maleadt/thesis-adastra3/scriptie/0_acronyms.tex

\begin{acronym}[WYSIWYG]	% langste afkorting
\acro{abi}[ABI]{Application Binary Interface}
\acro{agpl}[AGPL]{\acs{gnu} Affero General Public License}
\acro{ajax}[Ajax]{Asynchronous JavaScript and XML}
\acro{ajp}[AJP]{Apache JServ Protocol}
\acro{api}[API]{Application Programming Interface}
\acro{arm}[ARM]{Advanced \acs{risc} Machine}
\acro{cc-by}[CC-BY]{\acl{cc} Attribution}
\acro{cc}[CC]{Creative Commons}
\acro{cc-sa}[CC-SA]{\acl{cc} ShareAlike}
\acro{corba}[CORBA]{Common Object Request Broker Architecture}
\acro{cpu}[CPU]{Central Processing Unit}
\acro{css}[CSS]{Cascading Style Sheet}
\acro{dcp}[DCP]{Device Control Protocol}
\acro{dhcp}[DHCP]{Dynamic Host Configuration Protocol}
\acro{dns}[DNS]{Domain Name System}
\acro{dru}[DRU]{Design Rules}
\acro{dsp}[DSP]{Digital Signal Processor}
\acro{dvd}[DVD]{Digital Versatile Disc}
\acro{eabi}[EABI]{Embedded \acs{abi}}
\acro{eeprom}[EEPROM]{Electrically Erasable Programmable Read-Only Memory}
\acro{fpu}[FPU]{Floating-Point Unit}
\acro{fsf}[FSF]{Free Software Foundation}
\acro{ftp}[FTP]{File Transfer Protocol}
\acro{gcc}[GCC]{\acs{gnu} compiler collection}
\acro{gnu}[GNU]{GNU's Not Unix!}
\acro{gpl}[GPL]{\acs{gnu} General Public License}
\acro{gpu}[GPU]{Graphics Processing Unit}
\acro{hid}[HID]{Human Interface Device}
\acro{html}[HTML]{Hypertext Markup Language}
\acro{http}[HTTP]{Hypertext Transport Protocol}
\acro{hvsp}[HVSP]{High-Voltage Serial Programming}
\acro{ip}[IP]{Internet Protocol}
\acro{isp}[ISP]{In-System Programming}
\acro{jar}[JAR]{Java ARchive}
\acro{jit}[JIT]{Just In Time}
\acro{jna}[JNA]{Java Native Access}
\acro{jni}[JNI]{Java Native Interface}
\acro{jre}[JRE]{Java Runtime Environment}
\acro{jtag}[JTAG]{Joint Test Action Group}
\acro{jvm}[JVM]{Java Virtual Machine}
\acro{kde}[KDE]{K Desktop Environment}
\acro{lan}[LAN]{Local Area Network}
\acro{lgpl}[LGPL]{\acs{gnu} Lesser General Public License}
\acro{lufa}[LUFA]{Lightweight USB Framework for AVRs}
\acro{mac}[MAC]{Media Access Control}
\acro{maven}[Maven]{Apache Maven}
\acro{mdns}[mDNS]{Multicast \acs{dns}}
\acro{mit}[MIT]{Massachusetts Institute of Technology}
\acro{moc}[MOC]{Meta-Object Compiler}
\acro{mpl}[MPL]{Mozilla Public License}
\acro{nas}[NAS]{Network Attached Storage}
\acro{oabi}[OABI]{Old \acs{abi}}
\acro{ohl}[OHL]{Open Hardware License}
\acro{pcb}[PCB]{Printed Circuit Board}
\acro{pll}[PLL]{Phase-Locked Loop}
\acro{pom}[POM]{Project Object Model}
\acro{raid}[RAID]{Redundant Array of Independent Disks}
\acro{ram}[RAM]{Random Access Memory}
\acro{rest}[REST]{Representational State Transfer}
\acro{rhel}[RHEL]{Red Hat Enterprise Linux}
\acro{risc}[RISC]{Reduced Instruction Set Computer}
\acro{rmi}[RMI]{Remote Method Invocation}
\acro{rpc}[RPC]{Remote Procedure Call}
\acro{sasl}[SASL]{Simple Authentication and Security Layer}
\acro{scpd}[SCPD]{Service Control Protocol Description}
\acro{sd}[SD]{Secure Digital}
\acro{sl}[SL]{Scientific Linux}
\acro{soap}[SOAP]{Simple Object Access Protocol}
\acro{soc}[SoC]{System-on-a-Chip}
\acro{srt}[SRT]{SubRip subtitle}
\acro{ssdp}[SSDP]{Simple Service Discovery Protocol}
\acro{ssl}[SSL]{Secure Socket Layer}
\acro{svn}[SVN]{Apache Subversion}
\acro{uart}[UART]{Universal Asynchronous Receiver/Transmitter}
\acro{upnp}[UPnP]{Universal Plug and Play}
\acro{usb}[USB]{Universal Serial Bus}
\acro{uuid}[UUID]{Universally Unique Identifier}
\acro{webdav}[WebDAV]{Web-based Distributed Authoring and Versioning}
\acro{wtfpl}[WTFPL]{Do What The Fuck You Want Public License}
\acro{wysiwyg}[WYSIWYG]{What You See Is What You Get}
\acro{xml}[XML]{eXtensible Markup Language}
\acro{xsd}[XSD]{XML Schema Definition}
\end{acronym}
