maleadt/thesis-adastra3/scriptie/4_inputmodule.tex

\part{Inputmodule}
\label{inputmodule}

\chapter{Hardware}
\label{inputmodule:hardware}

Zoals uit de doeken gedaan in deel \ref{ontwerp}, zullen we voor de module gebruik maken van een AVR microcontroller met daarop de V-USB firmware om low-speed datacommunicatie te verwezenlijken met minimale periferie.

\section{Microcontroller}
\label{inputmodule:hardware:microcontroller}

Door het gebruik van de V-USB bibliotheek moeten we ons beperken tot AVR microcontrollers, maar binnen die familie is het aanbod nog altijd zeer groot. Om een goede selectie te maken, moeten we logischerwijs rekening houden met de eisen die de V-USB bibliotheek stelt:
\begin{itemize}
\item Flash: tenminste 2 kB;
\item RAM: tenminste 128 bytes;
\item Kloksnelheid: 12.8 of 16.5 MHz bij gebruik van een interne oscillator, en ook 12, 15, 16 of 20 MHz indien we gebruik maken van een extern kristal\footnote{Dit omdat enkel de 12.8 en 16.5 MHz frequenties een deviatie van 1\% toelaten, en het bij de interne oscillator onmogelijk is om een heel precieze afstelling te bekomen.};
\item Poorten: exact 2, beide met een interruptlijn.
\end{itemize}

We willen echter ook een uitbreidbare module realiseren. Momenteel hebben we slechts 4 knoppen aan te sluiten, maar mogelijks worden dit er later meer. Daarom zullen we ruimte laten voor drie extra knoppen, wat we eenvoudig kunnen realiseren met slechts 4 poorten door het signaal te multiplexen. Als we tenslotte overlappingen negeren, volstaat het zelfs om maar 3 poorten te gebruiken.

Tenslotte zou het ook interessant zijn moest de microcontroller voorzien zijn van \ac{isp} headers, waardoor de firmware van de module achteraf nog kan vernieuwd worden zonder daarvoor de microcontroller te moeten verwijderen uit de module. Indien we het echter mogelijk willen maken om de chip te herprogrammeren via \ac{isp}, kunnen we geen gebruik maken van \ac{hvsp} (waarvoor de chip fysiek in een \ac{hvsp} programmer moet geplaatst worden). \ac{hvsp} is een speciale methode om een microcontroller te programmeren, waarbij het mogelijk is om voordien ingestelde \emph{fuses} opnieuw in te stellen. Zo is er bijvoorbeeld de fuse die de \code{RESET}-poort (aanwezig op elke AVR microcontroller) configureert als een reguliere input/output poort. Deze fuse kan initieel wel ingesteld worden via \ac{isp}, maar heeft als consequentie dat de chip nadien niet meer kan geherprogrammeerd worden, tenzij door gebruik te maken van \ac{hvsp} waarmee de fuse in kwestie opnieuw ingesteld kan worden. Hierdoor is het dus onmogelijk om de \code{RESET}-poort te gebruiken als reguliere poort.

Een microcontroller die voldoet aan deze eisen, is de \strong{AtTiny45}. Deze heeft de volgende relevante specificaties:
\begin{itemize}
\item Flash: 4 kB;
\item RAM: 256 bytes;
\item EEPROM: 256 bytes;
\item ISP: aanwezig;
\item Kloksnelheid: 10 MHz voor de low-voltage versie, en tot 20 MHz voor de reguliere versie;
\item Interne oscillator: gekalibreerd voor 8 MHz;
\item Voedingsspanning: 1.8-5.5 volt voor de low-voltage versie, en 2.7-5.5 volt voor de reguliere versie.
\end{itemize}

\subsection{Kloksnelheid}

Om het aantal componenten te minimaliseren, zouden we de module graag realiseren zonder gebruik te maken van een externe oscillator. De interne oscillator is echter enkel gekalibreerd om op 8 MHz te werken, wat niet bruikbaar is in combinatie met V-USB. Om toch een bruikbare frequentie te bekomen, maken we gebruik van een kalibratiemechanisme dat we vonden in het \makeurl{http://www.obdev.at/products/vusb/easylogger.html}{EasyLogger} voorbeeldproject.

De eerste stap bestaat uit het kalibreren van de interne oscillator tot een frequentie van 8.25 MHz, dit door te vergelijken met binnenkomende \ac{usb} frames en binair te zoeken naar een optimale waarde voor het \code{OSCCAL} oscillator kalibratieregister. Hierdoor zal de \ac{pll} clock, steeds gelijk aan een achtvoudige versnelling van de interne oscillator, ingesteld worden op 66 MHz. Indien we tenslotte de \code{CLKSEL} fuse bij het programmeren instellen op $0001$ zal de systeemklok gelijk ingesteld worden aan de \ac{pll} clock gedeeld door 4, wat overeen komt met 16.5 MHz, een frequentie die we kunnen gebruiken in combinatie met de V-USB code.

\subsection{Voeding}

Aangezien de kloksnelheid waarop onze microcontroller zal draaien, 16.5 MHz, groter is dan 10 MHz, zullen we geen gebruik kunnen maken van de low-voltage versie. Meer nog: om een kloksnelheid groter dan 10 MHz te bekomen, zal de voedingsspanning zelfs tussen de 4.5 en 5.5 volt moeten bedragen. Op het eerste zicht vormt dit geen probleem, we kunnen immers de \ac{usb} voedingslijn (mits ontkoppeling) direct gebruiken om de microcontroller te voeden. Maar zoals uit de volgende paragraaf zal blijken, zou het zo ook zijn voordelen hebben moesten we de microcontroller kunnen voeden met een lagere spanning.

Natuurlijk zullen we ook de voedingsspanning ontkoppelen (zoals te zien is in figuur \ref{fig:inputmodule:voeding}), en dit op twee vlakken. Om de hoogfrequente schakelpieken van de digitale microcontroller af te vlakken, plaatsen we een 100 nanofarad condensator tussen de voedingslijn en de grondplaat. Het valt op te merken dat we die condensator zo dicht mogelijk tegen de voedingspin van de microcontroller willen plaatsen, dit om parasitaire capaciteiten te vermijden. Vervolgens willen we ook eventuele onregelmatigheden afvlakken (hetzij van de spanningsbron uit, hetzij veroorzaakt door een plotse toename in verbruik), waarvoor we een 10 microfarad condensator plaatsen aan de kant van de \ac{usb} connector. De waarde van 10 microfarad is niet uit de lucht gegrepen: ze is relatief hoog om de typisch laagfrequentere pieken die een spanningsbron genereert af te vlakken, en tegelijk is het ook het maximum dat de \ac{usb} specificatie toelaat \citep{usbnutshell}.

\begin{figure}
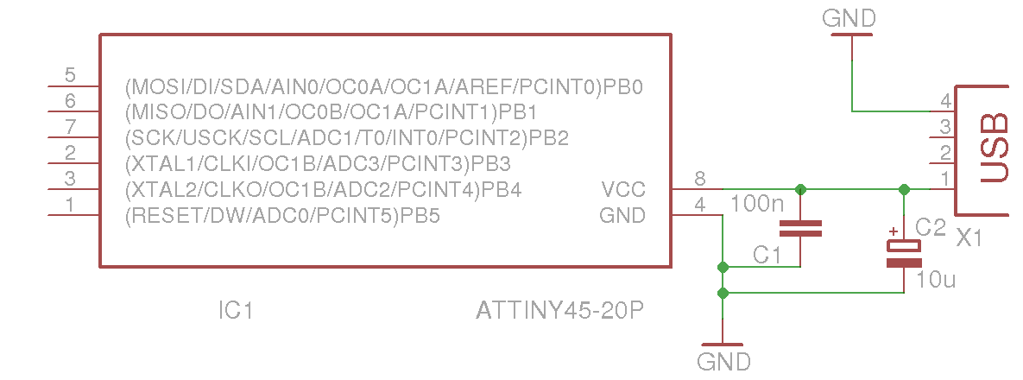
[picture p1: scriptie/afbeeldingen/inputmodule_voeding.png]
	
	\caption{Voedingscircuit}
	\label{fig:inputmodule:voeding}
\end{figure}

\subsection{Signalen}

\ac{usb} datacommunicatie verloopt steeds over een \emph{twisted-pair}, op een differentiële manier. Dit betekent dat een signaalbit afgeleid wordt uit het potentiaalverschil tussen de twee signaaldragers, en dat die binnen een \ac{usb}-kabel steeds gedraaid (\emph{twisted}) zijn. Het voordeel van het draaien is dat eventuele ruis grotendeels evenredig verdeeld is over beide kabels, waardoor het potentiaalverschil tussen beide vaak onveranderd blijft. Hierdoor is differentiële dataoverdracht over een twisted-pair veel beter bestand tegen elektromagnetische ruis.

Eerst en vooral zorgen we voor een stroombeperking op de signaaldragers. Hiertoe zullen we tussen de signaalpin en de \ac{usb} connector een weerstand van 68 ohm plaatsen, die ervoor zorgen dat er nooit meer dan 50 milliampères zal vloeien.

De specifieke elektrische kenmerken van de implementatie in het \ac{usb} protocol zijn vervelend voor gebruik in combinatie met de meeste digitale componenten. Zo wordt een hoog signaal gekenmerkt door een differentieel signaal van 2.8 tot 3.6 volt, terwijl voor een laag signaal 0 tot 0.3 volt te detecteren valt. Voor toekomende signalen (het twisted-pair is immers half-duplex) vormen deze waarden geen probleem: de meeste microcontrollers, waaronder de gebruikte AtTiny45, herkennen een signaal van 3.3 volt als een hoog signaal (hoewel de specificatie slechts een bereik vastlegt, sturen de meeste hosts exact 3.3 volt) . Wat wel een probleem vormt, zijn de uitgaande signalen. Aangezien onze microcontroller gevoed wordt door 5 volt, kennen de signalen tevens een spanning van 5 volt, wat ruimschoots buiten het opgelegde bereik valt.

Een mogelijke oplossing bestaat erin de \strong{voedingsspanning van de microcontroller te verlagen} tot 3.6 volt. Aangezien de spanning die de microcontroller gebruikt op de signaalpinnen min of meer gelijk is aan de voedingsspanning, en de AtTiny45 genoeg heeft aan slechts 1.8 tot 2.7 volt (afhankelijk van de uitvoering), zou dit het probleem direct oplossen. Er zou enkel nood zijn aan een spanningsregulator om de voedingsspanning te reduceren tot 3.6 volt, wat dan wel een \emph{low-drop} regulator zou moeten zijn (omdat gewone regulators meestal een initiële drop van 2 volt kennen). Een minder robuust alternatief vervangt deze regulator door twee diodes, waardoor een voltage drop van 1.2 tot 1.4 volt bekomen wordt.
Jammer genoeg kunnen we geen van deze oplossingen gebruiken, omdat de microcontroller op 16.5 MHz zal draaien waarvoor we een voedingsspanning tussen de 4.5 en 5 volt nodig hebben.

Een alternatief wordt geboden door het \strong{reguleren van het spanningsniveau van de signaalpinnen}. Hiertoe raadt de \makeurl{http://vusb.wikidot.com/hardware}{V-USB wiki} bijvoorbeeld aan om gebruik te maken van 3.6 volt zenerdioden. Zenerdioden hebben immers de eigenschap dat ze ook in sperstand kunnen geleiden, wanneer de zenerspanning bereikt is. Daarbij is de spanningsval over de diode dan ook relatief constant, los van de spanning die er aangelegd wordt. Meer concreet houdt dit in dat indien we de signaalpinnen via een zenerdiode in sper verbinden met de grondplaat, de spanning van het signaal gereduceerd wordt tot 3.6 volt. Deze opzet kent echter ook enkele problemen. Zo kan het moeilijk zijn om de exacte combinatie van parameters vast te leggen, zenerdiodes komen immers in soorten en maten. Een ander nadeel zijn de hoge stromen veroorzaakt door de zenerdiode. Wanneer de diode immers een hoog 5 volt signaal reduceert tot 3.6 volt, zal de overige 1.4 volt over de 68 ohm weerstanden tussen de microcontroller en de \ac{usb} host komen te staan, wat zorgt voor liefst 20 milliampères over de signaaldrager.

Tenslotte moeten we nog voorzien in een \emph{setting weerstand} die een spanning plaatst op de negatieve signaaldrager. Deze pull-up weerstand maakt aan de \ac{usb} host duidelijk dat er een \ac{usb} 1.1 toestel aangesloten is (weliswaar actief in \emph{low speed} modus). Voor een 5 volt lijn kan dit gerealiseerd worden met een 1k8 of 2k2 ohm weerstand. Het resultaat van dit alles is te zien in figuur \ref{fig:inputmodule:signaalconversie}.

\begin{figure}
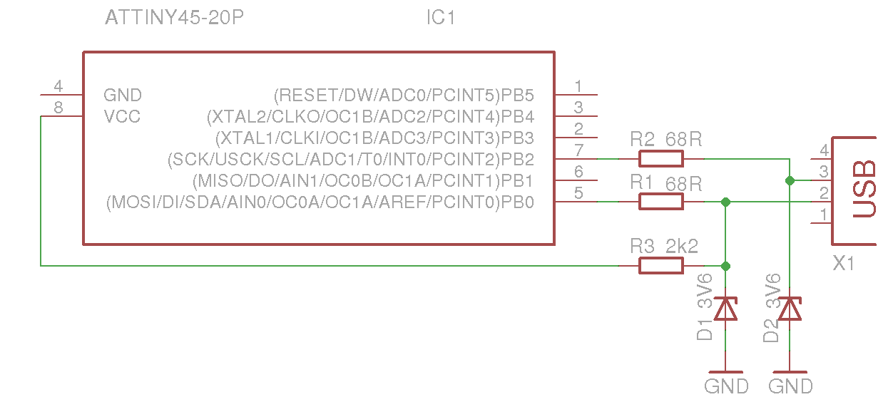
[picture p2: scriptie/afbeeldingen/inputmodule_signaal.png]
	
	\caption{Signaalconversie}
	\label{fig:inputmodule:signaalconversie}
\end{figure}

\subsection{\acs{isp}}

Het invoegen van een \ac{isp} header is niet veel werk: we dienen gewoon te voorzien in een connector, en de pinnen ervan correct door te verbinden met de juiste pinnen van de microcontroller (figuur \ref{fig:inputmodule:isp}).

\begin{figure}
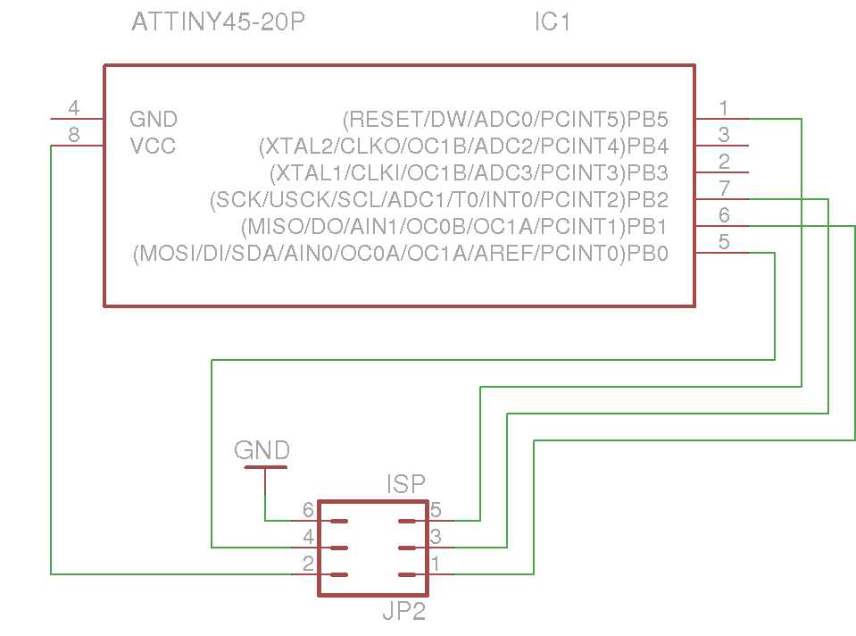
[picture p3: scriptie/afbeeldingen/inputmodule_isp.png]
	
	\caption{\acs{isp} connector}
	\label{fig:inputmodule:isp}
\end{figure}

\section{Schakelaars}
\label{inputmodule:hardware:schakelaars}

De schakelaars bevinden zich fysiek niet op de inputmodule, maar zijn reeds ingebouwd in de bestaande kasten. Daarom zullen we een systeem moeten bedenken om de bestaande schakelaars op een handige manier op de module aan te sluiten. Tevens moeten we de knoppen zodanig verbinden dat er uitbreidingsmogelijkheden zijn.

Om de bestaande schakelaars op een eenvoudige manier aan te sluiten, zullen we de inputmodule voorzien van een connector waarop we eenvoudig knoppen kunnen aansluiten. De meest robuuste oplossing hierbij is een connector die vastklikt op de module, waardoor die niet per toeval kan loskomen. Dergelijke connectors zijn echter vrij specifiek, en vereisen per aan te sluiten schakelaar een element op de printplaat. Een alternatief, dat als voordeel heeft dat het geen speciale connector aan de kant van de knoppen vereist, zijn vijs-connectors. Hierbij worden de losse draden van de knoppen via een vijsaansluiting op de printplaat bevestigd. Hoewel dit al een betere oplossing is, vereist het nog altijd een connector op de printplaat voor elke knop, en neemt het vast- en losvijzen van de kabels ook meer tijd in beslag dan het aansluiten van een eenvoudige connector. Daarom hebben we gekozen voor de alombekende \emph{jumpers}. Deze makkelijk te vinden connectors kunnen eenvoudig aan het kabelpaar van de knoppen bevestigd worden door middel van een krimptang. Aan de kant van de printplaat is het ook een eenvoudigere oplossing, daar het mogelijk is de aansluitingen voor alle schakelaars door middel van een enkel blok jumpers te realiseren. Het enige nadeel is dat aangesloten connectors niet zo vast zitten: bij gebrek aan weerhaak of ander systeem kan de kabel relatief gemakkelijk loskomen.

Om de aansluitingen op de printplaat eenvoudig te houden, zullen we werken met een \emph{active-low} mechanisme: een knop zal, wanneer ingedrukt, bepaalde signaallijnen doorverbinden met de elektrische grond. Om er voor te zorgen dat er een hoog signaal gemeten wordt wanneer er geen verbinding is met de elektrische grond, maken we gebruik van de interne pull-up die beschikbaar is voor elke poortpin: dit is een weerstand tussen de $20$ en $50$ kilo-ohm die de poortpin intern doorverbindt met de positieve voedingslijn. Hierdoor zal bij afwezigheid van een externe verbinding de spanning op de poortpin gelijk zijn aan de voedingsspanning, wat gedetecteerd wordt als een hoog signaal. Wanneer we echter de poortpin zullen doorverbinden naar de elektrische grond, zal deze pull-up weerstand zorgen voor een stroom tussen de $0.1$ en $0.25$ milliampères.

Er is echter een bijkomend probleem: we hebben maar 3 poortpinnen tot onze beschikking, waardoor het niet mogelijk is elke knop door te verbinden met een eigen poortpin. De eenvoudigste oplossing hiervoor is het gebruik van een multiplexer: 2 select-lijnen en 1 datalijn maken het mogelijk om 4 schakelaars uit te lezen. We willen echter meer knoppen kunnen aansluiten, zonder daarbij extra poortpinnen nodig te hebben. Daarom zullen we zelf het signaal multiplexen, waarbij we meer schakelaars kunnen toelaten door geen gebruik te maken van een selectiemechanisme, maar de signalen direct door te linken naar de poortpinnen. Het nadeel aan deze opzet is dat de signalen kunnen overlappen, zo zullen we bij het indrukken van meerdere knoppen tegelijkertijd niet kunnen uitmaken welke knoppen juist ingedrukt zijn. Maar dit kunnen we ook als een voordeel zien, omdat het zo mogelijk wordt om bijvoorbeeld een administratieve interface te openen door verschillende knoppen tegelijk in te drukken.

De realisatie van een dergelijke multiplexer lijkt eenvoudig, maar er is een belangrijk detail dat we moeten opmerken. Aangezien de verschillende poortpinnen verbonden zijn met verschillende knoppen, kan er bij het indrukken van een enkele schakelaar stroom terugvloeien via de contactpunten van diens signaallijnen met andere knoppen van een totaal ongerelateerde poortpin. Om dit te vermijden moeten we overal waar er twee signaallijnen met elkaar verbonden zijn, een diode plaatsen zodat er geen stroom kan terugvloeien naar een vorig verbindingspunt. Hiervoor hebben we een reguliere diode nodig, waarbij geen speciale eisen gesteld worden. Daarom kiezen we voor de 1N4148, een populaire diode die vaak gebruikt wordt voor het schakelen van digitale signalen. Zoals we kunnen opzoeken in het stroom-spanningsdiagram van deze diode, zorgt ze bij een stroom tussen $0.1$ en $0.25$ milliampères (gegenereerd door de pull-up weerstand binnen de microcontroller) voor een spanningsval van $0.5$ volt. Het schema dat dit alles realiseert is te vinden in figuur \ref{fig:inputmodule:schakelaars}.

\begin{figure}
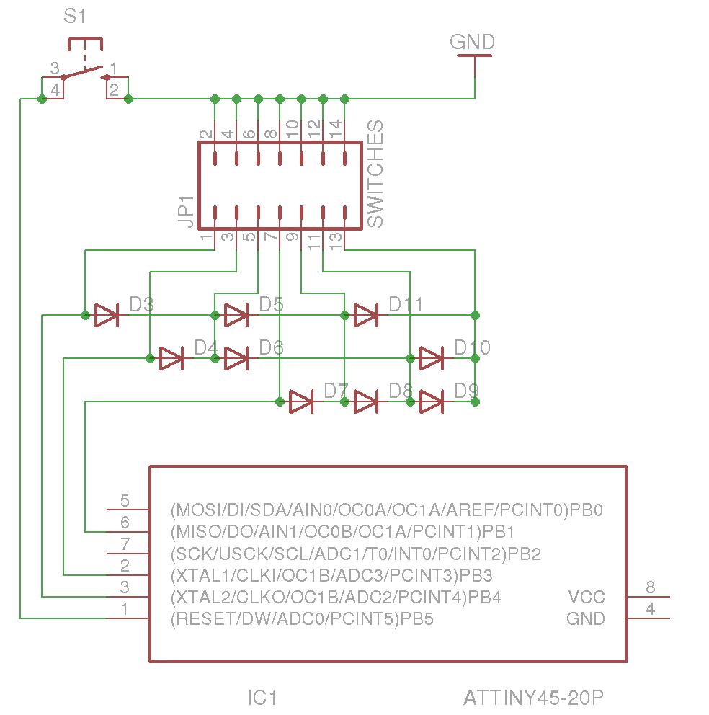
[picture p4: scriptie/afbeeldingen/inputmodule_schakelaars.png]
	
	\caption{Circuit en connector voor schakelaars}
	\label{fig:inputmodule:schakelaars}
\end{figure}

\section{Productie}
\label{inputmodule:hardware:productie}

De laatste stap bestaat uit de realisatie van het ontworpen schema en fysieke printplaat, ofte een \ac{pcb}. Hierbij moeten we manueel een fysieke layout aanmaken en baantjes trekken waar er stroom moet kunnen vloeien. De plaatsing van die componenten is echter niet louter willekeurig. Zo is het bijvoorbeeld interessant om de componenten efficiënt te plaatsen zodat de uiteindelijke printplaat zo klein mogelijk is. Maar er zijn ook andere zaken waarmee we moeten rekening houden. Zo is er bijvoorbeeld de kwestie van plaatsing van de ontkoppelingscondensatoren: die worden best zo dicht mogelijk bij de bron van de spanningsoscillaties geplaatst.

Eerst zijn we op zoek gegaan naar een fabrikant die voor een aanvaardbaar tarief een voldoende gesofisticeerde printplaat kan produceren. De mogelijkheden zijn eens te meer zeer uitgebreid, maar na een grondige vergelijking zijn we terechtgekomen bij \makeurl{http://www.eurocircuits.com/}{Eurocircuits}, een Europees bedrijf met verschillende vestigingen, waaronder België. Hoewel de verschillen tussen andere fabrikanten niet al te groot zijn, heeft de combinatie van een competitieve prijs, beperkte verzendkosten, en verschillende positieve kritieken ons ertoe overtuigd om voor de diensten van Eurocircuits te kiezen.

Dan hebben we gekeken naar de eisen en mogelijkheden die het goedkoopste van de productietypes te vinden bij Eurocircuits - de standard pool - biedt. De \makeurl{http://www.eurocircuits.com/images/stories/ec09/ec-standard-pool-overview-english-1-2010-v3.pdf}{volledige lijst} is te uitgebreid om hier te vermelden, daarom halen we enkel de belangrijkste elementen aan:
\begin{itemize}
\item Maximaal 8 layers;
\item Top- en bottom solder mask;
\item Top- en bottom silkscreen.
\end{itemize}
Om de overige eisen, denk maar aan de minimale afstand tussen boorgaten of de minimale breedte van elektrische baantjes, te controleren zullen we gebruik maken van een \ac{dru} bestand. Dergelijke bestanden worden vaak aangeboden door de fabrikant, en laten toe om geautomatiseerd alle eisen te controleren die aan een printplaat gesteld worden.

Om een printplaat of \ac{pcb} te ontwerpen hebben we natuurlijk gepaste software nodig. De meest populaire keuze hierbij is de EAGLE PCB software, ontwikkeld door \makeurl{http://www.cadsoftusa.com/}{CadSoft}, waarschijnlijk omdat er een beperkte variant van de software gratis beschikbaar is. Wegens de populariteit van de tool bestaat er een heel actieve community, waardoor een zeer uitgebreide selectie aan componenten beschikbaar is voor gebruik binnen EAGLE. Ook biedt Eurocircuits enkel \ac{dru} bestanden aan voor de EAGLE software. Het lijkt daarom een verstandige keuze om onze printplaat ook te ontwerpen met EAGLE.

Nu we alle nodige specificaties vergaard hebben en een softwarepakket geselecteerd hebben, kunnen we beginnen aan het produceren van de fysieke layout. Hierbij hebben we ervoor gekozen om een printplaat te maken die bestaat uit twee lagen, namelijk de boven en onderkant. Deze optie is niet veel duurder dan een 1-laags printplaat, en het geeft ons de nodige flexibiliteit om de componenten goed te kunnen plaatsen. Moesten we gekozen hebben voor een 1-laags printplaat dan zou de kost misschien zelfs hoger kunnen liggen door soms onnatuurlijke plaatsing om toch de nodige verbindingen te kunnen realiseren. 

De finale versie van de 2-laags printplaat is te vinden in figuur \ref{fig:inputmodule:pcb}. Hierbij zijn een aantal zaken waard om te vermelden. Zo is er de plaatsing van de 100 nanofarad condensator die instaat voor het ontkoppelen van de hoogfrequente ruis: aangezien dergelijke ruis veroorzaakt wordt door het schakelen van de transistoren binnen de microcontroller, hebben we de condensator zo dicht mogelijk geplaatst bij de bron van die ruis. Ook hebben we, zoals het de gewoonte is bij het ontwerpen van een schema, de vrije ruimte van elke laag gebruikt om een volledig geleidend vlak te maken. Daarbij zal de fill op de bovenste layer gebruikt worden om de positieve voedingsspanning $Vcc$ te geleiden, en de fill op de onderste layer om de elektronische grond te verdelen. Hoewel dit bij een hoogfrequent-circuit niet aan te raden is wegens de parasitaire capaciteiten die gepaard gaan met dergelijke \emph{plane fills}, is dit bij ons relatief laagfrequent schema niet van toepassing.

\begin{figure}
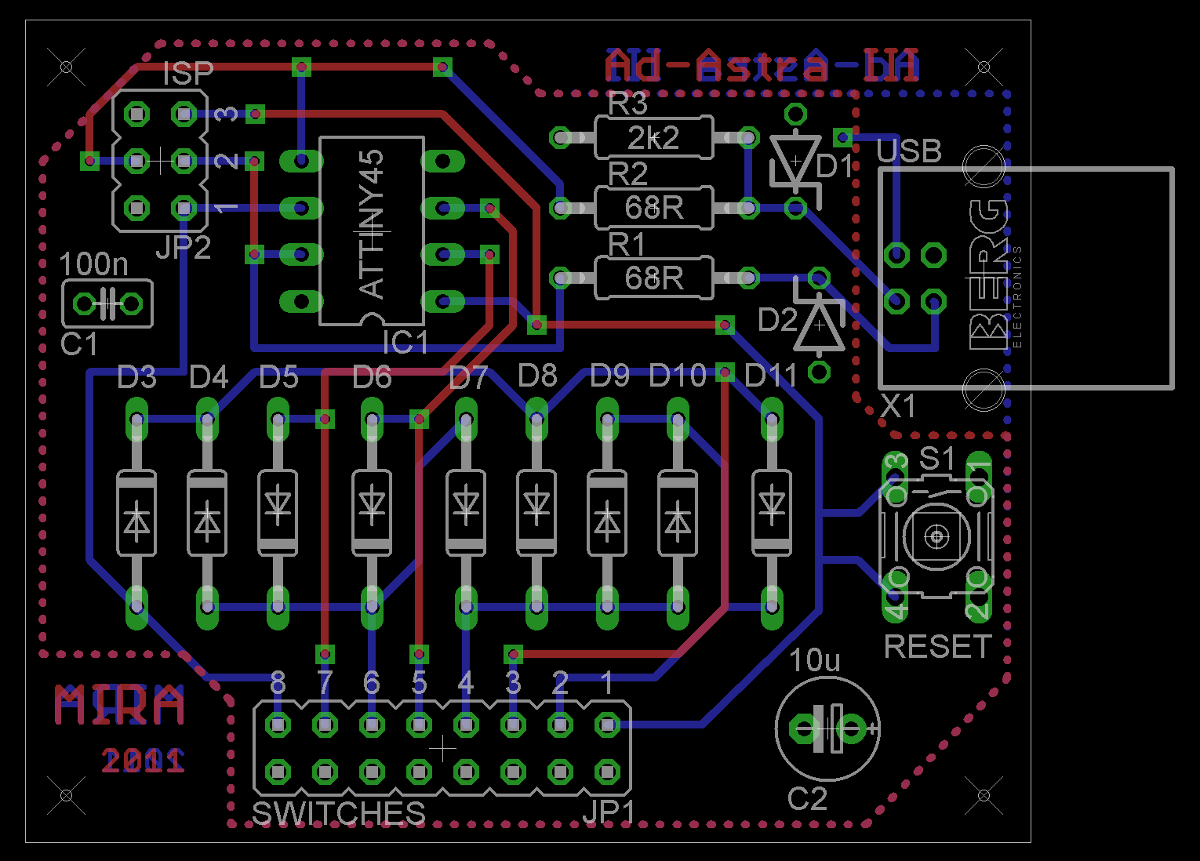
[picture p5: scriptie/afbeeldingen/inputmodule_pcb.png]
	
	\caption{Finale versie van de printplaat}
	\label{fig:inputmodule:pcb}
\end{figure}

De laatste stap voor de effectieve productie is de conversie van ons schema naar het bestandsformaat dat vereist is door Eurocircuits. Hoewel dit verschilt van producent tot producent, moeten we meestal voorzien in de volgende bestanden (met het formaat steeds tussen haakjes):
\begin{itemize}
  \item Top copper (Extended Gerber): koper op bovenste laag;
  \item Bottom Copper (Extended Gerber): koper op onderste laag;
  \item Top Silkscreen (Extended Gerber): tekst op bovenste laag;
  \item Top Soldermask (Extended Gerber): plaatsen op bovenste laag die moeten bedekt worden met beschermende laag;
  \item Bottom Soldermask (Extended Gerber): plaatsen op bovenste laag die moeten bedekt worden met beschermende laag;
  \item Drill File (Excellon): waar en hoe er geboord moet worden op de printplaat.
\end{itemize}

Het genereren van deze bestanden kunnen we uitvoeren met Eagle's CAM Processor. Hiertoe hebben we ons gebaseerd op een voorbeeld CAM job van Sparkfun, aangepast aan de specifieke eisen die Eurocircuit stelt. Na het insturen van deze bestanden, selectie van de benodigde materialen en processen, kregen we na enkele weken een afgewerkte printplaat in de bus. Vervolgens zijn we overgegaan tot aankoop van de benodigde componenten, waarna we die er op gesoldeerd hebben om dan eindelijk een afgewerkte print te bekomen zoals te zien in figuur \ref{fig:inputmodule:afgewerkt}.

\begin{figure}
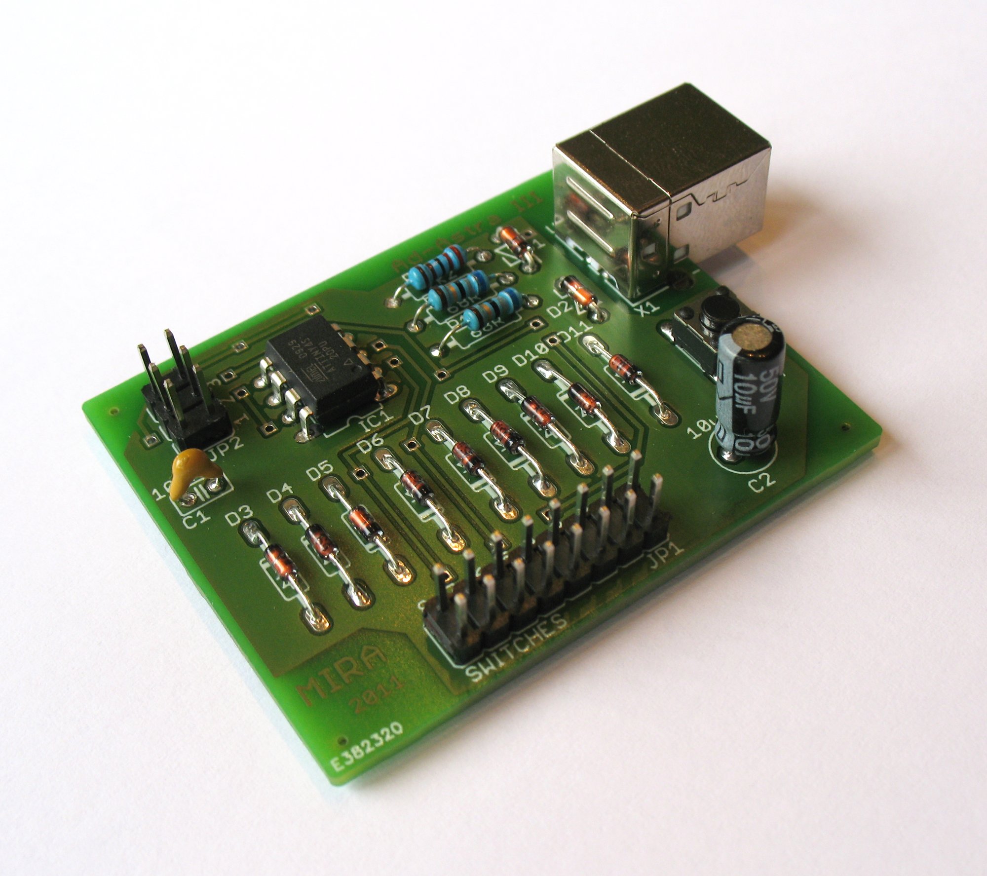
[picture p6: scriptie/afbeeldingen/inputmodule_afgewerkt.jpg]
	
	\caption{Finale versie van de inputmodule}
	\label{fig:inputmodule:afgewerkt}
\end{figure}

\chapter{Firmware}
\label{inputmodule:firmware}

\section{Geheugengebruik}
\label{inputmodule:firmware:geheugengebruik}

Bij het schrijven van de firmware moesten we rekening houden met de mogelijkheden van de chip. Deze eigenschappen, vermeld in sectie \ref{inputmodule:hardware:microcontroller}, waren vaak sterk beperkend. Zo hadden we maar 4 kilobytes tot onze beschikking, waardoor het moeilijk zou worden om (een subset van) C++ te gebruiken: de overhead teweeggebracht door het gebruik van klassen is immers te groot. Ook moesten we erop letten om geen \emph{floating-point} berekeningen uit te voeren: aangezien de AtTiny45 geen \ac{fpu} bevat, zou het gebruik ervan resulteren in het meelinken van een \ac{fpu}-emulator (die ruim 2 kilobytes groot is).

Ook moeten we rekening houden met de beperkte hoeveelheid \ac{ram} geheugen. Een voorbeeld van een dergelijke optimalisatie is hoe we 14 bytes \ac{ram} geheugen uitgespaard hebben bij de lookup-table waarmee een bitmap van geactiveerde schakelaars geconverteerd wordt naar de geschikte toetsaandruk. Aangezien we over 7 schakelaars beschikken, en er 1 extra entry in de lookup tabel aanwezig is voor wanneer er geen toets ingedrukt is, hebben we 8 ingangen nodig binnen de lookup-table. Voor elke ingang in die tabel, die we indexeren met de bitmap om zo geen extra ruimte te vereisen, hebben we twee waarden nodig: de toets, en een modifier (zoals \code{shift} of \code{alt}). Beide waarden worden geëncodeerd als een \code{uchar}, en nemen dus elk 1 byte in beslag. Hierdoor is de hele lookup-table exact 16 bytes groot. Omdat we deze tabel rechtstreeks indexeren moet ze volledig in het \ac{ram} geheugen staan, zélfs als we ze nooit zullen wijzigen. Om deze verkwisting te vermijden zullen we gebruik maken van de \code{PROGMEM} macro die ons toelaat om bepaalde datastructuren onder dwang in het programmageheugen op te slaan. Hoewel we daardoor 16 bytes uitsparen, moeten we nu meer opletten bij het gebruik van de lookup-tabel: de tabel is niet langer rechtstreeks te indexeren. Meer concreet: pointers die we berekenen door het optellen van een offset (de bitmap waarmee we normaal de tabel indexeerden) met het basisadres van de tabel mogen we nu niet langer rechtstreeks gebruiken om gegevens op te halen (\emph{pointer dereferencing}), maar enkel voor aanroepen van de \code{pgm\_read\_word} functie. Het resultaat, nu slechts 2 bytes groot, dienen we natuurlijk op te slaan in \ac{ram} geheugen.

\begin{lstlisting}[language=C, float, caption=Optimalisatie van de lookup-table.]
static const uchar keyReport[NUM_KEYS+1][2] PROGMEM = {
/* none */  {0, 0},
/*  1 */    {MOD_SHIFT_RIGHT, KEY_1},
/*  2 */    {MOD_SHIFT_RIGHT, KEY_2},
/*  3 */    {MOD_SHIFT_RIGHT, KEY_3},
/*  4 */    {MOD_SHIFT_RIGHT, KEY_4},
/*  5 */    {MOD_SHIFT_RIGHT, KEY_5},
/*  6 */    {MOD_SHIFT_RIGHT, KEY_6},
/*  7 */    {MOD_SHIFT_RIGHT, KEY_7},
};

static void handleKeyPress(uchar key)
{
    *(int *)data = pgm_read_word(keyReport[key]);
}
\end{lstlisting}

Tenslotte gebruiken we ook nog 1 byte uit het \ac{eeprom} geheugen om het resultaat van een succesvolle kalibratie in op te slaan. Die kalibratie is, zoals beschreven in sectie \ref{inputmodule:hardware:microcontroller}, nodig omdat we geen oscillator gebruikt hebben op de printplaat. Omdat die kalibratie echter enige tijd in beslag neemt, slaan we het resultaat ervan op zodat na een heropstart de kalibratie niet opnieuw moet uitgevoerd worden. Een overzicht van het totale geheugengebruik na deze optimalisaties is te vinden in tabel \ref{tbl:inputmodule:geheugengebruik}.

\begin{table}
  \begin{center}
    \begin{tabular}{c c c}
    Geheugen & Gebruik & Limiet \\
    \hline
    Flash & 2172 bytes & 4 kilobytes \\
    \ac{ram} & 61 bytes & 256 bytes \\
    \ac{eeprom} & 1 byte & 256 bytes \\
    \end{tabular}
  \end{center}
  \caption{Geheugengebruik van de firmware voor de inputmodule}
  \label{tbl:inputmodule:geheugengebruik}
\end{table}

\section{Codeanalyse}
\label{inputmodule:firmware:codenalyse}

Net zoals we bij de kioskapplicatie een probleem hadden om de constructies specifiek aan Qt te analyseren, was het ook niet eenvoudig de code van de firmware te controleren. Het probleem hierbij is dat de code opnieuw gebruik maakt van een groot aantal macro's en symbolen gedefiniëerd door een complexe combinatie van AVR-specifieke headers en symbolen die via de command-line aan de preprocessor doorgegeven worden. Om dit te illustreren leggen we uit hoe je een bit uitschrijft naar de eerste pin van de eerste uitwendige poort. De code daarvoor is eenvoudig, en werkt op alle AVR microcontrollers: \code{PORTA = (1<<PA1);}. Hierbij zijn er twee speciale symbolen in het spel: \code{PORTA} die naar de juiste I/O-registers van de poort wijst, en \code{PA1} die indiceert hoeveel plaatsen de bit moet opgeschoven worden om terecht te komen op het gedeelte van het I/O-register dat wijst naar de eerste pin van de poort.

Het is duidelijk dat de exacte inhoud van deze registers verschilt van model tot model, en dat die symbolen gebruikt worden om de code enigszins overdraagbaar te houden. Wanneer de code echter gecompileerd wordt, moeten deze symbolen vervangen worden door de juiste geheugenadressen en waarden. Daarvoor zorgen de headers uit de AVR C-library, tegelijk een mooie illustratie van de mogelijkheden die de C preprocessor biedt. Een illustratief voorbeeld van hoe het \code{PA1} symbool door de preprocessor zal omgezet worden, is te zien in fragment \ref{lst:avr:preprocessor}.

\begin{lstlisting}[language=C, float, caption=Omzetten van AVR symbolen via preprocessor-logica., label=lst:avr:preprocessor]
#ifndef _AVR_ATTINY13A_
  #define PA1 2
  #define PA2 1
  #define PA3 0
#elif _AVR_ATTINY45PU_
  #define PA1 0
  #define PA2 1
  #define PA3 2
  #define PA4 4
#else
  #error Unknown microprocessor model.
#endif
\end{lstlisting}

Zoals blijkt uit fragment \ref{lst:avr:preprocessor} berust de preprocessor op enkele symbolen die door de programmeur moeten gespecificeerd worden. Die symbolen moeten gedefiniëerd zijn wanneer de preprocessor de code verwerkt, wat in de praktijk vaak gedaan wordt door een header te includen (bijvoorbeeld \code{settings.h}) die als enige taak heeft die kritieke symbolen te definiëren. Wij hebben er echter voor gekozen om de symbolen door te geven aan de compiler en preprocessor via de command-line, waardoor we alle configuratie kunnen isoleren binnen de \code{Makefile}.

Het grote probleem met al deze preprocessor-logica is dat statische analyse-tools er vaak niet goed mee overweg kunnen. Het is ook geen oplossing om eerst de preprocessor zijn werk te laten doen omdat de code dan vaak niet meer herkenbaar is en het voor de programmeur dan niet te doen is om de output van de analysetools correct te interpreteren. Daarom hebben we, zeker gezien de beperkte grootte van de firmware (nog geen 250 regels code) besloten om niet verder te zoeken naar analysetools en gewoon zelf de code eens extra grondig te controleren.

\section{Compilatie}
\label{inputmodule:firmware:compilatie}

Het grote probleem bij het compileren van de firmware is dat de machinecode die de AVR microcontroller vereist niet compatibel is met de x86-machinecode die een compiler op onze computers genereert. We zullen dus een compiler moeten gebruiken die specifiek geconfigureerd is om machinecode te genereren die kan draaien op een ander systeem dan hetgeen waar de compiler op uitgevoerd wordt. Dit proces heet \emph{cross compiling}.

Als we kijken naar de bekendere open-source compilers is de AVR versie van \ac{gcc} de de facto standaard voor het compileren van code voor AVR microprocessoren. Ook zou het gebruiken van een andere compiler ervoor zorgen dat we flink wat code zouden moeten converteren om überhaupt nog te kunnen compileren. Veel van de preprocessor-logica beschreven in sectie \ref{inputmodule:firmware:codenalyse} is immers geïmplementeerd met \ac{gcc}-specifieke instructies (ook wel \emph{compiler intrinsics} genoemd). Als we bijvoorbeeld naar een andere kwalitatieve compiler kijken, IAR's Embedded Workbench, moeten we zelf afhankelijk van het model microprocessor bepalen welke header we gebruiken, en is het natuurlijk niet mogelijk om daarvoor de \ac{gcc} headers te gebruiken die wel voorzien in een handige abstractielaag.

Om toch toch nog enigszins aan codeanalyse te doen hebben we vervolgens \ac{gcc} dusdanig geconfigureerd dat het zoveel mogelijk potentiële fouten detecteert en uitschrijft. Dit hebben we gedaan met de \code{-Wall} en \code{-Wextra} parameters, waarmee we een probleem hebben ontdekt betreffende pointer uitlijning.
