maleadt/thesis-adastra3/verslag/verslag-a4.tex

%
% Configuratie
%

% Preambule met standaardinstellingen
\documentclass[a4paper,oneside,11pt,final]{memoir}

% Noot: zorg ervoor dat Nederlandse woord-splitsing geactiveerd is.
\usepackage[dutch]{babel}

% UTF8 gebruiken voor gebruik van alle symbolen
\usepackage[utf8]{inputenc}
\usepackage{eurosym}
\DeclareUnicodeCharacter{03A9}{\Omega}

% Noot: je kan het graphicxpakket een optie dvips of pdftex doorgeven
% in dat geval moet je ze ook aan iiiscriptie doorgeven, dus bijvoorbeeld
% \usepackage[dvips]{graphicx}
% \usepackage[dvips]{iiiscriptie}
\usepackage{graphicx}
\usepackage{iiiscriptie}

% Tabellen eleganter maken
\usepackage{booktabs}

% Navigeerbaarheid van hyperlinks in PDF
\usepackage{hyperref}

% Afkortingen intelligent gebruiken
\usepackage[printonlyused,withpage]{acronym}

% Math support
\usepackage{amssymb,amsmath}

% Extra functies
\input{functies.tex}

%
% Titelpagina
%

% Invullen velden
\departement{Departement Toegepaste Ingenieurswetenschappen}
\deptadres{Schoonmeersstraat 52 - 9000 Gent}
\studiejaar{1e Master Informatica}
\soortrapport{Scriptie voorgelegd tot het behalen van de titel van Master in de Toegepaste Ingenieurswetenschappen}
\title{Ontwikkeling van een museumkiosk}
\bedrijfslogo{}
\author{Tim BESARD}
\promotoren{Leen BROUNS, Philippe MOLLET}

%
% Inhoud
%

\begin{document}

\pagenumbering{roman}
\input{0_begin.tex}
\newpage

\pagenumbering{arabic}
\input{1_introductie.tex}
\input{2_ontwerp.tex}
\input{3_server.tex}
\input{4_kiosk.tex}
\input{5_interface.tex}
\input{6_invoering.tex}

\input{0_einde.tex}

\end{document}
