maleadt/thesis-adastra3/verslag/3_ontwerp.tex

\part{Ontwerp}
\label{part:ontwerp}

%
% Systeemmodel
%

\chapter{Systeemmodel}
\label{chap:systeemmodel}

De eerste stap van het ontwerp was de identificatie van de verschillende deelsystemen, en op welke toestellen die te vinden zijn. Hiertoe hebben we eerst gekeken naar de verschillende taken die het systeem als een geheel moet vervullen. Zo moet het systeem:
\begin{itemize}
\item Voorstellingen weergeven, en gebruikersinput verwerken;
\item Toelaten om eenvoudig voorstellingen te wijzigen, zonder veel technische kennis;
\item Voorzien in een gebruiksvriendelijke beheersinterface;
\item Dit alles voldoende robuust uitvoeren.
\end{itemize}

Vervolgens hebben we de deelsystemen geïdentificeerd. Zo zijn er natuurlijk de kiosken, die instaan voor het weergeven van de voorstellingen, en het verwerken van gebruikersinput. Om het systeem flexibel te houden, zullen we de kiosken zo inrichten dat zowel de configuratie als de weer te geven voorstellingen zich niet op voorhand op de kiosk bevinden, maar van een centrale server gehaald worden. Diezelfde centrale server kan dan ook voorzien in een beheersinterface, waarbij de status van de verschillende kiosken gevisualiseerd wordt, en de administrator eventueel bepaalde acties kan ondernemen. Al deze functionaliteit zullen we bundelen binnen het specifiek hiervoor ontworpen applicatie-raamwerk, waarvoor we ook een communicatieprotocol zullen voor moeten definiëren.

\todo{Eventueel vermelden van monitoring systeem.}

\begin{figure}
	
	\caption{Ontplooiingsdiagram}
\end{figure}

In de volgende hoofdstukken zullen we nu elk van deze deelsystemen, en al wat daar bij hoort, tot in details uitwerken. Zo zullen we ook frequent bestaande technologieën hergebruiken, of net een gerichte keuze maken zodat hergebruik mogelijk wordt. Daarbij gaan we meestal uit van een initiële selectie aan technologieën die gebruikt kan worden om een specifiek doel te bekomen, waarna de selectie uitgedund wordt tot er slechts 1 mogelijkheid overblijft. Het valt op te merken dat we bij dergelijke selectieprocedures steeds een impliciete doch sterke voorkeur zullen stellen voor gratis technologieën, die voorzien in een cross-platform en open-source implementatie. Dat we kiezen voor gratis technologieën, vloeit voort uit het beperkte budget dat toegekend is door de MIRA vzw. Het cross-platform aspect is belangrijk omdat op termijn de applicatie misschien op een ander systeem zal moeten draaien, alsook het interessant zou zijn om indien het product succesvol blijkt, het open te stellen voor andere bedrijven. Het open-source kenmerk tenslotte kent zijn oorsprong misschien deels in idealistische gronden, maar blijkt in de praktijk ook zeer praktisch te zijn. Zo is het tijdens de realisatie van het project verschillende keren extreem nuttig gebleken om vrije toegang te hebben tot de broncode van de bibliotheek.

%
% Applicatie
%

\chapter{Applicatie}
\label{chap:applicatie}

Het volgende hoofdstuk zal het ontwerp van de applicatie bespreken. Daarbij zullen we eerst de technologieën vastleggen die we zullen bespreken, en pas dan de effectieve componenten waarop de applicatie draait (namelijk het servergedeelte, en het kioskgedeelte). In realiteit was dit proces echter niet zo afgelijnd: vaak werd er op een keuze teruggekomen wegens het veranderen van een of andere voordien gemaakte keuze. Bij verschillende keuzes zal het dan ook voorkomen dat een specifieke eis uit het niets gegrepen lijkt, of bevooroordeeld lijkt. Toch is dit niet het geval, pas na afloop van het hoofdstuk zal het complexe plaatje duidelijk worden en zullen alle beslissingen mooi in hun voegen vallen.

\section{Voorstellingen}
\label{sec:voorstellingen}

\subsection{Formaat}

Aan het formaat van de voorstellingen worden een aantal specifieke eisen gesteld:
\begin{itemize}
\item Efficiënt te distribueren over het netwerk;
\item Flexibel en toekomstgericht;
\item Terugwaarts compatibel met de huidige voorstellingen;
\item Laagdrempelig.
\end{itemize}

Zoals reeds gezegd bevinden de oude voorstellingen zich op een Dvd-schijf, in videoformaat. Het nieuwe formaat moet dus in staat zijn om video's weer te geven, eventueel mits bepaalde conversies.

Na verschillende formaten vergeleken te hebben, hebben we besloten gebruik te maken van een combinatie van HTML5 en Javascript. Die combinatie wordt vaak op het web gebruikt voor de weergave van tekst en multimedia, en laat toe om heel dynamische voorstellingen te ontwerpen. Ook is het mogelijk om, zonder enige aanpassing aan het omliggende raamwerk, gebruik te maken van Javascript bibliotheken, waardoor de mogelijkheden onbegrensd zijn.

Hoewel de mogelijkheden enorm zijn, zal de weergave van dergelijke voorstellingen nog relatief eenvoudig kunnen gerealiseerd worden. Dit omdat HTML en Javascript al jarenlang weergegeven worden binnen webbrowsers. We zullen dus de vruchten kunnen plukken van decennia aan ontwikkeling, door gebruik te maken van de \emph{rendering engines} van verschillende browsers.
\todo{Vermelden Gecko, WebKit?}

Sinds de nieuwste versie van de HTML standaard, HTML5, is er ook voorzien in een \texttt{<video>} tag, die toelaat om videofragmenten weer te geven. Hierdoor voldoen we ook aan de vereiste terugwaartse compatibiliteit, al is het met enige beperkingen. Momenteel is het immers nog niet duidelijk welke videostandaard algemeen zal ondersteund worden in de \texttt{<video>} tag, meer nog, er woedt een hele strijd tussen de verschillende fabrikanten en ontwikkelaars. Afhankelijk van welke versie van welke rendering engine we gebruiken, zullen we moeten kiezen uit een andere verzameling videostandaarden.
\todo{Vermelden WebM,H264,Theora?}

Ook efficiënte netwerktransmissie wordt bekomen door gebruik te maken van HTML en Javascript. Alle code wordt immers opgeslagen in tekstformaat, en de videostandaarden (los van welke we uiteindelijk zullen gebruiken) zijn steeds geselecteerd wegens hun nut in context van webpagina's, waar efficiënte compressie al even belangrijk is. Wanneer men een nieuwe voorstelling ontwerp kan men zelf door gebruik te maken van het volledige spectrum aan mogelijkheden die HTML5 biedt, de vertraging opgelopen door netwerktransmissie volledig verwaarlozen (vectorafbeeldingen in plaats van bitmaps, scripted animaties in plaats van videobestanden, ...).

Tenslotte is dit formaat voor de voorstellingen ook zeer laagdrempelig. Veel mensen hebben een basiskennis over HTML, en indien ze dit niet hebben is het eenvoudig te leren via de overvloed aan tutorials die er beschikbaar zijn. Ook is er geen nood aan een \emph{toolchain}: zowel HTML als Javascript bronbestanden kunnen gewijzigd worden in elke tekstverwerker, en compilatie is al helemaal overbodig.
Een mogelijk probleem is de beperkte scheiding tussen design en logica: wanneer dynamiek vereist is, moet de ontwerper nogal snel enige kennis hebben van Javascript. Toch kan dit verholpen worden door gebruik te maken van WYSIWYG-editors, al moet het gezegd worden dat die anno 2011 nog niet zo goed gebruik maken van alle mogelijkheden die deze nieuwe standaard biedt.

\subsection{Repository}

Zoals hierboven reeds vermeld, zullen de nieuwste voorstellingen zich niet direct op de relevante kiosken bevinden, maar op de centrale server. Dit maakt het gemakkelijk voor de administrator om wijzigingen door te voeren. Daartoe moeten we echter wel voorzien in een systeem dat toelaat om snel en efficiënt de nieuwe versie op te halen van de centrale server.

Initieel zijn we op zoek gegaan naar een \textbf{database-systeem} om dit te implementeren. Hoewel dergelijke systemen vooral sterk zijn in het herbergen van structurele data, zou het perfect mogelijk zijn om er voorstellingen in op te slaan. Efficiënte overdracht wordt echter niet voorzien, alsook zou het vrij moeilijk zijn om een gebruiksvriendelijke interface te bouwen bovenop dit systeem.

Een andere verzameling technologieën die we overwogen hebben, waren de \textbf{Enterprise Content Management} systemen. Hierbij vinden we al vaker een geïntegreerde beheersinterface, alsook wordt al vaker efficiëntere distributie bekomen door te voorzien in een versiebeheer-systeem. Toch voldeed deze oplossing niet, daar bij dergelijke systemen de nadruk vaak nog nadrukkelijker ligt op gestructureerde data, waardoor het niet praktisch zou zijn om er onze ongestructureerde voorstellingen in op te slaan.

Daarom hebben we uiteindelijk te stap gemaakt naar gedediceerde \textbf{versiebeheer-systemen}. Hierbij is efficiënte overdracht van gegevens een basiseigenschap, alsook zorgt het bestandsgeoriënteerde aspect voor een relatief gebruiksvriendelijk beheer. Zo kan een administrator heel gemakkelijk lokaal enkele wijzigingen doorvoeren aan een voorstelling, het resultaat testen in zijn browser, en indien gewenst zijn werk doorsturen naar de centrale server.

Maar er bestaan tientallen versiebeheersystemen, die we elk gepeild hebben aan ons eisenpakket:
\begin{itemize}
\item Client-server georiënteerd;
\item Efficiënte omgang met binaire bestanden.
\end{itemize}

Gezien de uiteindelijke keuze van het applicatieprotocol (zie onderdeel \ref{sec:applicatieprotocol}), komen hier nog twee eisen bij:
\begin{itemize}
\item Te beveiligen via SSL;
\item Te gebruiken over HTTP.
\end{itemize}

Er zijn maar weinig versiebeheersystemen die aan dit eisenpakket voldoen. Meer nog, na een uitgebreide selectie overlopen te hebben, blijkt enkel Subversion een geschikte keuze te zijn. Voor Subversion bestaan er tevens Java-bindings, te vinden in de \texttt{SVN-J} bibliotheek, waardoor de repository als 1 geheel zou kunnen geïntegreerd worden met de rest van de serverapplicatie. Jammer genoeg is de bibliotheek echter niet matuur genoeg voor integratie binnen het systeem, waardoor we zullen moeten gebruik maken van een overkoepelende webserver zoals Apache. Hierdoor wordt de binding tussen de applicatie en de repository iets minder sterk (wat bijvoorbeeld extra configuratie zal vereisen), maar het is de trade-off nodig om een realistisch systeem te bekomen.

\section{Applicatieprotocol}
\label{sec:applicatieprotocol}

Het applicatieprotocol staat in voor de communicatie tussen de verschillende componenten. Omdat dit protocol instaat voor verschillende taken, zullen we dan ook gebruik maken van verschillende protocollen, elk meest geschikt voor de taak die ze moeten realiseren.

Omdat we er naar streven om geen configuratie te voorzien op de kiosken, zal een kiosk na aanmelding op 1 of andere manier moeten geconfigureerd worden. We kiezen ervoor om die configuratie uit te laten gaan van de server, die via een \textbf{remote procedure protocol} de nodige configuratiemethodes op de kiosk aanroept. Hiertoe moet bij aanmelding van een kiosk, de server een bericht krijgen, wat we kunnen realiseren met een \textbf{service discovery protocol}. Vervolgens moet de kiosk, na geconfigureerd te zijn, weten welke voorstelling hij moet weergeven, en waar hij die moet halen. Hiervoor staat het \textbf{dataprotocol} in.

\subsection{Beveiliging}

Ook is het vanuit bedrijfsperspectief steeds interessant om bepaalde methodes van beveiliging te overwegen. Encryptie is niet belangrijk, daar geen van de verzonden data gevoelige informatie blootgeeft. Een vorm van authenticatie is echter wel interessant, om te voorkomen dat een kwaadwillende derde de configuratie op een kiosk vervalst, of verkeerde voorstellingen publiceert. Voor het service discovery gedeelte zal blijken dat authenticatie minder belangrijk alsook moeilijk te implementeren is (het netwerk kan hoogstens vertraagd of licht verstoord worden, corruptie van gegevens is onmogelijk).

De overige twee protocollen willen we natuurlijk op een eenduidige manier van authenticatie kunnen voorzien. Hiertoe is het interessant om gebruik te maken van SSL, een matuur en momenteel ongenaakbaar systeem van beveiliging. Bovendien kunnen we, indien beide protocollen gebruik maken van HTTP transport, het beveiligingsaspect louter in de overkoepelende webserver implementeren, zodat de deelprotocollen zelf geen SSL moeten implementeren, maar toch beveiligd zijn door een robuust authenticatiemechanisme. Enkel voor clientside gebruik (wat belangrijk is voor de applicatieserver, die contact zal opnemen met een XMLRPC-interface op de kiosken) is dan wetenschap van het exacte gebruik van SSL nodig.

\subsection{Service discovery}

Service discovery is een onderdeel van de "Zeroconf" standaard, een verzameling technieken die instaat voor het initialiseren van een netwerk zonder daarbij te voorzien in expliciete configuratie. Service discovery staat daarbij in voor het ontdekken van andere toestellen, alsook eventuele services die erop aanwezig zijn. Meestal voorzien dergelijke protocollen in twee elementaire features: het \emph{publishen} van services, waarbij een toestel te kennen geeft wat zijn mogelijkheden zijn, en het \emph{browsen} van services, waarbij een toestel actief of passief op zoek gaat naar bepaalde services binnen het netwerk.

In de context van dit systeem zal een nieuwe kiosk na het opstarten zijn applicatie publiceren op het netwerk. Een eventuele server zal passief luisteren naar een dergelijke publicatie, en de informatie daarbij bekomen gebruiken om over te gaan tot configuratie van de kiosk in kwestie.

Opnieuw bestaan er verschillende technologieën die voorzien in deze elementaire functionaliteit. Opnieuw stellen we enkel bijkomende eisen om een selectie te kunnen maken:
\begin{itemize}
\item Vereist geen extra infrastructuur;
\item Cross-language implementatie;
\item Eenvoudig te gebruiken.
\end{itemize}

Een veelgebruikt protocol voor service discovery, is het Simple Service Discovery Protocol (SSDP), deel van het \textbf{Universal Plug and Play (UPnP)} systeem. Dit door Microsoft-ontwikkeld systeem, biedt een heel uitgebreid en generisch raamwerk voor service discovery, waarbij die services volledig beschreven worden door Device Control Protocols (DCP). Het geheel steunt sterk op XML en SOAP, en is strikt beheerd door het UPnP Forum. Hoewel het protocol essentieel wel voldoet aan onze eisen, is het groot en log, en biedt het veel te veel mogelijkheden die we toch niet gaan gebruiken.

Een compacter alternatief is \textbf{multicast DNS (mDNS)}, onderdeel van het door Apple ontwikkelde Zeroconf systeem. Zoals de naam doet vermoeden, is dit een multicast uitbreiding van het \textbf{Domain Name System (DNS)}, dat via \texttt{SRV} records toelaat om services te publiceren. Dit is een veel eleganter systeem, essentieel slechts een eenvoudige uitbreiding van een bestaande technologie, maar kent zo ook zijn tekortkomingen. Zo worden bijvoorbeeld de mogelijkheden van elke service gedetailleerd via een ongespecificeerd tekstveld. Dergelijke tekortkomingen zijn echter niet van belang in de context van dit systeem, waardoor we zullen kiezen voor dit systeem. Bovendien kent mDNS bindings voor zowel Java als Qt, de twee frameworks die we zullen gebruiken bij de effectieve realisatie van de deelsystemen (zie sectie \ref{sec:server} en \ref{sec:kiosk}).

\subsection{Remote procedure}

Van zodra de server weet heeft van een nieuwe kiosk, moet die overgaan tot de configuratie ervan. Ook moet het mogelijk zijn om acties teweeg te brengen, bijvoorbeeld ten gevolge van acties in de beheersinterface. Daarom zijn we niet op zoek gegaan naar specialistische configuratieprotocollen, maar eerder naar meer generieke \emph{remote procedure} protocollen.

Opnieuw bestaan er vele verschillende remote procedure protocollen, elk met hun specifieke eigenschappen. Grotere enterprise-projecten geven vaak de voorkeur aan technologieën zoals \textbf{SOAP} of \textbf{CORBA}, enorme systemen die zeer uitgebreide mogelijkheden kennen. We zullen dergelijke technologieën echter om dezelfde reden vermijden als waarom we mDNS boven UPnP verkozen hebben: in de context van dit project is een compacter en eleganter protocol veel beter te controleren en dus interessanter dan een complex te configureren alleskunner waarvan de helft van de mogelijkheden toch onbenut blijven.

In de categorie van compactere RPC-protocollen vinden we zo bijvoorbeeld \textbf{REST}. Hoewel dit lichtgewicht, HTTP-gebaseerd, en ook vaak gebruikt protocol op het eerste zicht aan onze eisen voldoet, kent het zijn mindere kanten. Zo kent het geen eenduidige manier om fouten terug te geven, alsook is het formaat waarin data verstuurd wordt niet gestandaardiseerd. Omdat het manueel voorzien van deze mogelijkheden nog vrij veel werk zou innemen, besteden we verder geen aandacht aan dit protocol.

De meest courante ontwikkelframeworks zoals .NET en Java kennen meestal ook hun eigen RPC-protocol, zoals \textbf{WMI} en \textbf{RMI}. Hoewel deze protocollen meestal vrij matuur en veelzijdig zijn, zijn ze vaak niet cross-platform en zeker niet cross-language, waardoor ze tevens afvallen.

Ook hebben we meer moderne RPC-frameworks overwogen zoals \textbf{Apache Etch}, of \textbf{Apache Thrift}. Deze vrij nieuwe en tevens veelbelovende systemen bleken echter enkele kritieke eisen mis te lopen. Zo kent Apache Etch slechts een beperkte verzameling language bindings, en kent geen van beide een authenticatiemechanisme. Omdat beide verlopen over een eigen protocol, vallen ze ook niet te overkoepelen onder een SSL webserver.

Daarom hebben we uiteindelijk gekozen voor \textbf{XML-RPC}, een zeer simplistisch RPC-protocol dat XML-geformatteerde berichten verstuurd over HTTP transport. Hierdoor wordt het mogelijk om op een transparante manier een vorm van authenticatiecontrole toe te voegen. Toch kent XML-RPC ook zijn fundamentele problemen, zoals het inefficiënte berichtformaat. Omdat we berusten op een apart dataprotocol, is dit echter geen groot probleem. Ook is de specificatie, zacht uitgedrukt, vrij beperkt. Dit kan echter een voordeel zijn: de ermee geïmplementeerde interface wordt er compact mee gehouden, en valt eenvoudig te gebruiken vanuit verschillende talen. Dit wordt ook vereenvoudigd door de uitgebreide waaier aan implementaties, die er voor quasi elke taal is.

\subsection{Data uitwisseling}

In eerste instantie was het niet de bedoeling gebruik te maken van een derde deelprotocol, maar om de data te versturen over het RPC protocol. Na enig onderzoek bleek echter dat zowel het gebruik van een geïntegreerd datasysteem (zie \ref{sec:voorstellingen}), als het integreren van een versiebeheersysteem, niet zou lukken.

Nu voorzien we echter in een apart versiebeheersysteem (Subversion), dat vaak gebruikt wordt in aaneenschakeling met een webserver. Hierbij wordt het de communicatie bekomen over het WebDAV protocol, dat tevens over HTTP getransporteerd wordt. Dit laat ons opnieuw toe op eenvoudige wijze authenticatie toe te voegen, alsook ontlast het ons RPC protocol van de effectieve dataoverdracht.

\section{Redundantie en robuustheid}
\label{sec:redundantie}

Een belangrijk aspect van het systeem is dat het robuust is, en dus voorziet in een bepaalde vorm van redundantie. Zoals het hardwareontwerp zal verduidelijken (zie hoofdstuk \ref{chap:hardware}), voorzien we reeds in hardwarematige redundantie onder de vorm van een RAID opstelling. Toch verhelpt dit het fundamentele probleem niet: de centrale server is een \emph{single point of failure}.

Een eerste idee om dit te verhelpen was het voorzien van een \textbf{backup server}, die de centrale server continu zou monitoren. In geval van diens falen, zou de failover functionaliteit geactiveerd worden, waarbij de taken van de centrale server integraal overgenomen zouden worden. Gezien het configuratieloze aspect van de opstelling, en het feit dat elk initiatief steeds van de servers uit komt, zou dit totaal geen actie vereisen. Om ervoor te zorgen dat de backup server steeds over de meest recente informatie beschikt, activeert die tevens een (passieve) mDNS module, alsook registreert die zich bij de primaire server zodat updates aan de presentatie-repository steeds op beide servers aanwezig zijn.
Hoewel deze configuratie zeer elegant lijkt (zeker indien de replicatie alsook promotie/degradatie van de server volledig autonoom verloopt), is ze niet realistisch op budgettair vlak. Het is niet alleen kostelijk om een tweede voldoende krachtige server samen te stellen, maar de aanwezigheid ervan betekent een extra continue energieconsumptie.

Daarom hebben we gekozen voor een tweede piste, namelijk het gebruik van een \textbf{backup-cache in de kiosken}. Aangezien embedded hardware vaak komt met een optie voor een kaartslot, is het voordeliger om voor elke kiosk een dergelijke geheugenkaart aan te kopen, en de applicatie te voorzien van de functionaliteit om bij het opvragen van de configuratie en voorstellingen die lokaal op te slaan. Wanneer vervolgens de centrale server onbereikbaar blijkt te zijn, kan steeds gebruik gemaakt worden van deze lokale cache om toch volwaardig te kunnen blijven functioneren.

\section{Server}
\label{sec:server}

\section{Raamwerk}

\section{Structuur}

\begin{figure}
	
	\caption{Structuur van de serverapplicatie}
\end{figure}

\section{Kiosk}
\label{sec:kiosk}

%
% Monitoring
%

\chapter{Monitoring}
\label{chap:monitoring}

%
% Hardware
%

\chapter{Hardware}
\label{chap:hardware}
