maleadt/thesis-adastra3/scriptie/0_begin.tex

%
% Copyright
%

% Dit is pagina 2 omdat er nog een kopie van het titelblad achter komt
% (maar LaTeX kan dat niet renderen).
\thispagestyle{empty}

\null
\vfill

Copyright © 2011 Tim Besard

\vspace{1cm}

\begin{wrapfigure}{l}{2.5cm}
\vspace{-10pt}
\centering
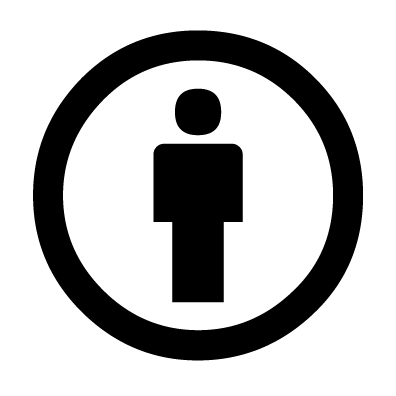
[picture p11: scriptie/afbeeldingen/creative-commons-by.png]

\end{wrapfigure}

\noindent \nohyphens{Dit werk is gelicensieerd onder de Belgische Creative Commons Naamsvermelding 2.0 licentie (\code{CC BY 2.0 BE}). Een kopie van deze licentie is te verkrijgen op de \makeurl{http://creativecommons.org/licenses/by/2.0/be/}{website van Creative Commons}, of door een brief te sturen naar \texttt{Creative Commons, 171 Second Street, Suite 300, San Francisco, California, 94105, USA}}.

\cleardoublepage

%
% Titelpagina
%

\maketitle

%
% Abstract
%

\setcounter{page}{3}

\selectlanguage{dutch}
\begin{abstract}
Het doel van deze thesis is de ontwikkeling van een modern multimediaframework ter vervanging van het verouderde systeem in de volkssterrenwacht MIRA. Het framework moet instaan voor de opslag, distributie, en weergave van multimediafragmenten, alsook de nodige middelen bieden zodat een designer er aantrekkelijke en veelzijdige voorstellingen kan voor ontwerpen.

Eerst en vooral wordt het systeem ingedeeld in de nodige deelsystemen, en hebben we na een grondige studie vastgelegd hoe die deelsystemen met elkaar communiceren. Zo zal de opslag en distributie gerealiseerd worden door een centrale server, die de kiosken zal detecteren en configureren via Zeroconf netwerkprotocollen. Dataopslag en -overdracht zal gerealiseerd worden door gebruik te maken van een versiebeheersysteem, waarbij de voorstellingen zullen gebruik maken van moderne webtechnologieën.

Vervolgens worden alle deelsystemen geïmplementeerd, wat inhoudt dat we een client- en serverapplicatie schrijven, deze laatste tevens uitgerust met een webinterface om het beheer te vereenvoudigen. Ook zorgen we voor de nodige hardware om beide applicaties op uit te voeren, waarbij we steeds een gepast besturingssysteem samenstellen. Om gebruikersinvoer op de kiosken te kunnen verwerken ontwikkelen we een inputmodule, waarvoor we een printplaat ontwerpen en zorgen voor de bijhorende firmware.

Tenslotte voorzien we ook nog in een speciale voorstelling waarmee de huidige media kan hergebruikt worden binnen het nieuwe framework.

\ 

\textbf{Sleutelwoorden}: multimediaframework; museumkiosk; opslag; distributie; versiebeheer; weergave; webtechnologieën.

\end{abstract}

\clearpage

\selectlanguage{english}
\begin{abstract}
The purpose of this applied dissertation is to develop a modern multimedia framework replacing an outdated system in the astronomy museum MIRA. The framework has to take care of data storage, distribution, and visualisation. It should also offer the means for a designer to develop visually appealing and versatile presentations.

Before all else, we divide the system in several subcomponents, and determine the exact interface between them. In order to do this, we carefully select the best technologies to accomplish each task: storage and distribution shall be taken care of by a central server, discovering and configuring any clients using Zeroconf network protocols. To accomplish efficient storage and distribution, a version control system will be used. Finally, the presentations will be built using modern web technologies.

Subsequently we proceed to the actual implementation of each subsystem, consisting of a client and server application to perform all of the necessary tasks, the latter one extended with a web interface to ease administration. To run these applications, we select appropriate hardware and compile an operation system. We also provide the kiosks with an input module to take care of any user input, which includes designing a printed circuit board and developing the proper firmware.

Finally we take care of a special presentation allowing us to reuse the current presentations within the new framework.

\ 

\textbf{Keywords}: multimedia framework; museum kiosk; storage; distribution; version control; visualisation; web technologies.

\end{abstract}

\selectlanguage{dutch}

\clearpage

%
% Woord vooraf
%

\chapter*{Woord vooraf}
\addcontentsline{toc}{chapter}{Woord vooraf}

Dit eindwerk is de slotsom van de 4-jaar durende opleiding tot industrieel ingenieur informatica aan de Hogeschool Gent, en is gerealiseerd geweest aan de volkssterrenwacht MIRA te Grimbergen.

Vooreerst gaat mijn dank uit naar mijn externe promotor, Philippe Mollet, die mij de vrijheid heeft gegeven om dit project op mijn eigen manier aan te pakken. Alhoewel dergelijke vrijheid niet altijd even goed samengaat met de beperkte ervaring van een student, is het er een extra leerrijke oefening door geworden.

Vervolgens wil ik mijn ouders bedanken voor de kans die ze mij gegeven hebben om deze opleiding tot een goed einde te brengen, en specifiek mijn vader om onvermoeibaar deze scriptie overlezen te hebben.

Ook dank ik mijn promotor, Leen Brouns, voor haar steun en foutloos corrigeerwerk tijdens de loop van het project.

Tenslotte nog een speciaal woord voor mijn vrienden en medestudenten, op wiens raad en enthousiasme ik altijd kan rekenen.

\begin{flushright}
Gent, augustus 2011
\end{flushright} 

\clearpage

%
% Inleiding
%

\chapter{Inleiding}
\label{inleiding}

De volkssterrenwacht MIRA biedt zijn bezoekers een uitgebreide rondleiding over sterrenkunde en aanverwanten. Aangezien het overgrote deel van de bezoekers bestaat uit kinderen (de sterrenwacht wordt vaak in schoolverband of door families bezocht), doet men sinds jaar en dag moeite om de rondleiding zo interessant mogelijk te maken, ook wanneer er geen gids is om daarvoor te zorgen. Daartoe heeft men enkele jaren geleden een project gelanceerd, genaamd \emph{Ad-Astra I}. Het doel van dit project was om multimediale kiosken te introduceren, waarbij de bezoeker via een aanraak-interface een keuze kan maken tussen verschillende multimediafragmenten. Zo staat er bijvoorbeeld bij de zaal over maanlanding een kiosk die de gebruiker toelaat om naar geluidsfragmenten van de Apollo 11 bemanning te luisteren.

Hoewel de kiosken professioneel ogen en hun werk degelijk uitvoeren, zijn er enkele problemen met het huidige systeem. De multimediafragmenten bevinden zich namelijk op een \ac{dvd} en worden verwerkt door een \acs{dvd}-speler, waarbij de gebruikersinterface bestaat uit 4 grote knoppen intern doorverbonden met de afstandsbediening.
Het grote probleem met deze opzet is de levensduur: een \acs{dvd}-speler die continu actief is, verslijt snel. Vervanging van de \acs{dvd}-speler is ook niet eenvoudig, omdat het model dat indertijd aangekocht is niet meer verkocht wordt en nieuwe modellen niet altijd compatibel zijn met de afstandsbediening in de kiosk.
Ook zijn de mogelijkheden die het systeem biedt, sterk beperkt. Alle interactiviteit moet immers geïmplementeerd worden via \acs{dvd}-menu's, wat niet veel meer toe laat dan eenvoudige selectie van het multimediafragment.

Vandaar dit project, wat de interne naam \emph{Ad-Astra III} heeft meegekregen. Voorafgegaan door Ad-Astra I (introductie van de kiosken) en II (vernieuwing van het telescopenpark), zal het instaan voor de vernieuwing van de kiosken. Het uiterlijk zal hetzelfde blijven: een kiosk zal nog steeds aangestuurd worden met 4 grote knoppen, en de voorstellingen zullen weergegeven worden op het (niet aanraakgevoelige) LCD scherm dat nu al gebruikt wordt, eventueel uitgebreid met een set aan luidsprekers.
Intern zal het systeem echter volledig anders werken. Een duurzame en energiezuinige chip haalt de voorstellingen op van een centrale server, waardoor het makkelijker zal zijn wijzigingen aan te brengen en die ook direct weer te geven op de kiosken. Ook zal elke kiosk continu in verbinding staan met het netwerk, wat beter beheer en weergave van dynamisch materiaal toelaat. Tenslotte zullen de voorstellingen opgebouwd zijn in een flexibel framework, wat toelaat veel rijkere inhoud weer te geven.

Deze scriptie zal beginnen met een uiteenzetting over het algemeen ontwerp in deel \ref{ontwerp}: hoe wordt het systeem gemodelleerd, voor welke technologieën is er gekozen, welke eisen worden aan de hardware gesteld, enzovoort.
Vervolgens wordt de realisatie van elk van de deelsystemen uit de doeken gedaan: de server in deel \ref{server}, de kiosk in deel \ref{kiosk}, en de ontwikkeling van de interface module in \ref{inputmodule}.
Tenslotte wordt er aandacht besteed aan de voorstellingen die het systeem zal weergeven in deel \ref{voorstellingen}. Hierbij zullen we spreken over de mogelijkheden die het systeem biedt, de code die op het prototype draait om die mogelijkheden te demonstreren, en het mechanisme dat gebruikt wordt om oudere voorstellingen zonder al te veel werk te kunnen importeren in het nieuwe systeem.

\clearpage

%
% Inhoudsopgave
%

\setlength\cftpartnumwidth{4em}
\tableofcontents

\clearpage

%
% Lijst van afkortingen
%

\chapter*{Lijst van afkortingen}
\markboth{List van afkortingen}{Lijst van afkortingen}
\addcontentsline{toc}{chapter}{Lijst van afkortingen}
\input{0_acronyms.tex}
\acresetall
\clearpage
