maleadt/thesis-adastra3/scriptie/corpus.tex

%
% Configuratie
%

% Preambule met standaardinstellingen
\documentclass[a4paper,oneside,11pt,final]{memoir}

% Noot: zorg ervoor dat Nederlandse woord-splitsing geactiveerd is.
\usepackage[dutch,english]{babel}

% UTF8 gebruiken voor gebruik van alle symbolen
\usepackage[utf8]{inputenc}
\usepackage{eurosym}
\DeclareUnicodeCharacter{03A9}{\Omega}

% Afbeeldingen inladen
\usepackage{graphicx}

% Tabellen eleganter maken
\usepackage{booktabs}

% Navigeerbaarheid van hyperlinks in PDF
\usepackage{hyperref}

% Afkortingen intelligent gebruiken
\usepackage[printonlyused,withpage]{acronym}

% Math support
\usepackage{amssymb,amsmath}

% Figure wrapping (voor CC BY vermelding)
\usepackage{wrapfig}

% Listings
\usepackage{listings}
\lstset{captionpos=b, frame=tb}

% Tonen van LaTeX counters (gebruiken footnotes binnen tabel)
\usepackage{fmtcount}

% Tijdelijk uitschakelen van hyphenation
\usepackage{hyphenat}

% Bibliografie
\usepackage{natbib}

% Extra functies
\input{functies.tex}

% Informatie voor titelpagina
\input{titelpagina.tex}

%
% Corpus
%

\begin{document}

\frontmatter
\input{0_begin.tex}

\mainmatter
\input{1_ontwerp.tex}
\input{2_server.tex}
\input{3_kiosk.tex}
\input{4_inputmodule.tex}
\input{5_voorstellingen.tex}

\appendix

\backmatter
\input{0_einde.tex}

\end{document}
