maleadt/thesis-adastra3/scriptie/titelpagina.tex

% Mogelijk maken om afbeeldingen te gebruiken
\usepackage{graphicx}

% Stijl
\usepackage{iiiscriptie}

% Invullen velden
\departement{Departement Toegepaste Ingenieurswetenschappen}
\deptadres{Valentin Vaerwyckweg 1, 9000 Gent}
\studiejaar{1e Master Informatica}
\soortrapport{
Scriptie voorgedragen tot het behalen van het diploma van\\
MASTER IN DE TOEGEPASTE INGENIEURSWETENSCHAPPEN: INFORMATICA\\
}
\title{Ontwikkeling van een multimediaframework}
\bedrijfslogo{}
\author{Tim BESARD}
\promotoren{
Intern:& Leen BROUNS \\
Extern:& Philippe MOLLET}
