maleadt/thesis-adastra3/scriptie/functies.tex

% Hyperlink maken en URL in footnote tonen
\usepackage{hyperref}
\newcommand{\makeurl}[2]{\href{#1}{#2} \footnote{#1}}

% Semantische stijl
\renewcommand\emph{\textit}
\newcommand\code{\texttt}
\newcommand\strong{\textbf}

% Extra talen voor lstlistings
\lstdefinelanguage{JavaScript}{
  keywords={typeof, new, true, false, catch, function, return, null, catch, switch, var, if, in, while, do, else, case, break},
  ndkeywords={class, export, boolean, throw, implements, import, this},
  sensitive=false,
  comment=[l]{//},
  morecomment=[s]{/*}{*/},
  morestring=[b]',
  morestring=[b]"
}
\lstdefinelanguage{JavaProperties}{
  sensitive=true,
  comment=[l]{\#},
  morestring=[b]',
  morestring=[b]"
}
\lstdefinelanguage{ApacheConfig}[]{XML}{
  morekeywords={Location, LimitExcept},
  comment=[l]{//},
}
