maleadt/thesis-adastra3/Probleemstudie.odt

# Museumkiosk – Probleemstudie

Vervangen van een gedateerde kiosk-infrastructuur door een flexibel en toekomstgericht informatica-systeem.

Dit document beschrijft de verschillende deelproblemen die met dit project gepaard gaan, alsook eventuele oplossingen ervoor.

## Voorstellingen

Een flexibel en krachtig systeem om presentaties te creëren, is de combinatie van HTML5 en Javascript. Gebruik makende van de nodige libraries kan hiermee een uitgebreide en mooie presentatie gecreëerd worden. Toch zijn er ook nadelen:

- De conversie vergt veel werk.
- Minder duidelijke scheiding tussen design en programmeren.

De huidige presentaties zijn normale DVD's, waarbij alle interactiviteit gerealiseerd is via het menu van de DVD. Enkele getallen over deze presentaties:

- Grootte: tussen te 1,05 en 1,75 GB
- Duur: meerdere tientallen minuten film in 3 talen.
- Bitrate: 7 Mb/s voor geluid en video (piek van 10 Mb/s)
- Benodigde infrastructuur voor 20 clients:
  - 100 Mb/s clients (10% capaciteit)
  - 1 Gb/s server (20% capaciteit)
  - 100 Mb/s infrastructuur, met 1 Gb/s backplanes

Het origineel formaat van de presentaties is dus niet geschikt voor deployment over een netwerk. Ook elimineert de grootte elke mogelijkheid van lokale caching. Daarom zal moeten gekeken worden naar een krachtiger compressieformaat. Enkele getallen voor een dergelijk modern compressieformaat, waarbij zowel de gekozen codec (x264) als de compressieparameters (equivalent betreffende beeldkwaliteit met de huidige presentaties) natuurlijk nog moeten geherevalueerd worden:

- Bitrate: 2,5 Mb/s (312,5 KB/s)
- Benodigde infrastructuur voor 20 clients:
  - 10 Mb/s clients (25% capaciteit)
  - 100 Mb/s server (50% capaciteit)
  - 100 Mb/s infrastructuur

Aangezien het niet de bedoeling is om binnen het bestek van het eindwerk alle presentaties om te vormen naar het HTML5/Javascript formaat (wat bovendien veel te veel tijd zou kosten), moeten de huidige presentaties kunnen weergegeven worden. Toch is het ook niet de bedoeling om aan flexibiliteit in te boeten wegens de legacy van het project, waardoor de twee vormen van presentaties naast elkaar zullen moeten kunnen leven.

Gelukkig voorziet de HTML5 specificatie in mogelijkheden om videos weer te geven binnen een reguliere pagina. Zo kunnen we als eerste stap de huidige presentaties omvormen naar een efficiënt formaat om ze dan te embedden binnen een HTML5 pagina. In een later stadium kan het bedrijf dan de bestaande presentaties te hermaken in HTML5/Javascript, of (realistischer) nieuwe presentaties vanaf nu aan maken in het nieuw formaat.

Om toch binnen het bestek van dit eindwerk de mogelijkheden van het HTML5/Javascript formaat te illustreren, zal zeker 1 kiosk geconverteerd of opnieuw ontworpen worden.

## Kiosk

Taken:

- Weergave van presentaties
- Verwerken van gebruikersinput via inputchip

### Hardware

Vereisten:

- Energieconsumptie: totaalpakket (zonder de LCD televisies) onder 20W
- Verwerkingssnelheid: de gebruikerservaring moet vlot genoeg zijn.
  - Videopresentaties
    - Snelle CPU (SIMD support voor moderne decoders)
    - Voldoende netwerksnelheid (zie hoger)
  - HTML5/Javascript presentaties
    - GPU met acceleratiemogelijkheden (OpenGL ondersteuning, eventueel meer specifiek voor vb. Qt)
- Aansluitingsmogelijkheden
  - USB
  - HDMI of DVI met HDMI convertor
  - Ondersteuning voor onboard solid-state bootmedium
- Levensduur: minimaal 5 jaar
- Geluidsproductie: te minimaliseren.
  - Geen bewegende opslagmedia
  - Passief gekoeld
- Andere
  - Wake On Lan?

Specificatie – mogelijke pistes:

- Embedded-oriented hardware (ARM, Via EPIA, BeagleBoard)
  - Voordelen
    - Small form-factor, embedded-oriented design (passief, kan tegen stofopstapeling, etc)
    - Handige features:
      - Onboard Flash en/of CF/SD
      - Dedicated acceleration peripherals (video, DSP, ...)
    - Levensduur
  - Nadelen
    - Statischer geconfigureerd
- Consumer-grade hardware (Intel Atom, Via, AMD Fusion)
  - Voordelen
    - Flexibeler
    - Computing power laat toe om gemis aan hardware features op te vullen
      - CPU
      - GPU: general acceleration via OpenGL shaders (QtWebKit), video acceleration (Xv, VA-API, VDPAU/XVBA)
  - Nadelen
    - Levensduur (valt wellicht wel mee, maar de hardware is er toch niet voor gemaakt)
    - Meer points of failure wegens meer aparte componenten (alhoewel recente Atom/Ontario configuraties soms al alles onboard hebben)
      - Harde schijf
      - RAM
    - Nutteloze features
      - 5.1 audio
      - SATA
      - RAID
- Thinclients – 2e hands (Compaq, HP)
  - Voordelen
    - Prijs (< €50)
    - Handige features
      - Onboard Flash en/of CF/SD
  - Nadelen
    - Underpowered
      - Levensduur (meeste zijn al verschillende jaren in gebruik)

De verschillende pistes afgewogen lijkt de embedded oplossing de beste, zeker omdat de configuratie meerdere jaren statisch zal functioneren, en er verwacht wordt dat die periode met een minimum aan hardwarefalen overbrugt wordt (harde-schijfen en andere externe perhiperals moeten dus vermeden worden). Toch zal de prijs uiteindelijk doorslaggevend zijn, eenmaal boven de €150-175 kan een consumer-grade oplossing voordeliger uitvallen.

Specificatie - voorbeeldconfiguraties:

- Embedded-oriented hardware
  - Omap3 based (TI chip met deftige ARM Cortex & DSP) Qt acceleratie: http://labs.qt.nokia.com/2009/11/20/building-qt-to-make-use-of-the-beagle-boards-sgx-gpu/ (http://labs.qt.nokia.com/2009/11/20/building-qt-to-make-use-of-the-beagle-boards-sgx-gpu/)
    - BeagleBoard http://beagleboard.org/hardware
      - Handige features
        - OpenGL ES 2.0
        - DVI
        - Integrated DSP
        - S-Video out
      - Geen ethernet
      - Vrij duur
    - IGEPv2 http://www.igep.es/index.php? (http://www.igep.es/index.php?option=com_content&view=article&id=46&Itemid=55)option=com_content&view=article&id=46&Itemid=55 (http://www.igep.es/index.php?option=com_content&view=article&id=46&Itemid=55)
      - Handige features (zelfde BeagleBoard)
        - Ethernet
      - Vrij duur (€150)
    - CM-T3530 http://processors.wiki.ti.com/index.php?title=OMAP3_Boards
      - Goede configuratie!
      - Vereist twee boards (1 met de features, 1 met de connectors)
      - Duur in kleine oplage
- Consumer-grade hardware
  - Intel Atom based
    - Geen GMA 500 based chips nemen: Poulsbo!
    - Intel D410PT http://ark.intel.com/Product.aspx?id=42646
      - GMA 3150 IGP
        - Full MPEG-2 acceleratie
        - Xv zou moeten werken http://intellinuxgraphics.org/documentation.html
        - Geen VA-API: slechts voor G45/GM45 en GMA 500
        - OpenGL 2.1 via Mesa , maar misschien maar 1.4 door HW/driver beperkingen.
  - AMD Fusion based
    - AMD Ontario (Zalcate tegenhanger is desktop/laptop oriented)
      - Oriented op embedded/netbook markt
      - GPU & CPU in 1 package
      - 9W TDP
      - Doorgedreven GPU acceleratie
      - Zeer goede Mesa drivers
      - Normaal Q4 2011
- Thinclients – 2e hands
  - Hogeschool Gent – Sector Informatisering
    - Compaq T20 Evo http://h18000.www1.hp.com/products/quickspecs/10865_div/10865_div.HTML#Technical%20Specifications
      - Cytrix GX1 – 300 Mhz http://en.wikipedia.org/wiki/Geode_%28processor%29#Geode_GX1
        - Geen SIMD, niet goed voor x264
      - Onboard FLASH
      - Firmware te vervangen met Etherboot image → PXE http://www.wlug.org.nz/CompaqEvoT20Notes http://www.kazak.com.co/evo/
    - NCD Thinstar http://wiki.nullstack.net/ThinSTAR_400
      - Welk model exact? Volgens de commentaar van de verantwoordelijke een low-end model (want ouder dan de Compaq), wellicht rond de 133 Mhz.

Deze configuraties vergeleken komen de embedded oplossingen er opnieuw goed uit. Toch belooft AMD's Ontario een extreem interessante chipset te zijn, zeker indien er een configuratie verschijnt die toch de benodigde features (zoals on-board solid state bootmedia om extra perhiperals te vermijden) bevat.

### Software

De applicatie moet een meerwaarde hebben boven een normale Desktop Environment (DE) met afgescheiden configuratie. Zo kent KDE bijvoorbeeld een “Kiosk Mode”, waarbij enkel de browser beschikbaar is, toegespitst tot een bepaald domein. Dat domein zou dan, gebaseerd op het MAC van de requester, andere bronbestanden kunnen aanbieden. Gebruik maken van dedicated software heeft echter voordelen:

- Lichter dan een volledige DE (geen DE libraries nodig, mogelijkheid tot lichtgewicht Windowing System zoals QWS, etc).
- Platform-onafhankelijk: de applicatie abstraheert platformspecifiek gedrag in een uniforme interface.
- Sluit dichter aan bij de vereisten van het bedrijf:
  - Interactie via alternatieve methodes.
  - Weergave van presentaties (de KDE Kiosk is ontwikkeld om gebruikers een beperkte werkomgeving te geven).

Hoewel dit van buitenaf gezien een bloated applicatie mag lijken (standaardfunctionaliteit steeds opnieuw geimplementeerd), is dit noodzakelijk om de applicatie platform-onafhankelijk te maken. Ook kan binnenin de applicatie steeds gebruik gemaakt worden van bestaande applicaties (UNIX-style).

Use cases (peilen bij andere musea, en literatuurstudie ter vergelijking met huidig aanbod):

- Weergave.
- Interactie.
  - Reageren op signalen van de presentatie
  - Surfen binnen een (beperkt) domein
  - Invullen van complexe informatie.
- Distributie.
  - Nieuwe versie van de software
  - Wijzigingen van presentaties
- Configuratie:
  - Systeemgedrag

Zowel het weergave als interactie-gedeelte kan eenvoudig gerealiseerd worden binnen een browser, met HTML5 en Javascript als basis. Het is dus logisch om de software rond een browser-framework (zoals Gecko of Webkit) te ontwerpen.

Vereisten:

- Automatisatie: heel het proces (opstarten, configuratie, fouthandeling, updating, ...) moet volledig autonoom verlopen.
- Gebruiksvriendelijk
  - Robuust: de applicatie mag nooit crashen, in een noodscenario moet de functionaliteit steeds behouden blijven.
  - Beveiligd: misbruik moet vermijden worden, zeker in conjunctie met een krachtige scripting engine.
- Herbruikbaar: alle kenmerken specifiek aan de huidige situatie moeten vermeden worden in de core codebase.
  - Qt: veel platform-afhankelijke programmatie kan opgevangen worden door gebruik te maken van dit cross-platform framework (biedt interfaces voor netwerk, audio, video, weergave, etc).
  - Scripted plugins: andere, meer specifieke taken, die platform- of situatieafhankelijk zijn kunnen beheerbaar gehouden worden door ze te migreren naar een plugin, eventueel geinterpredeerd via een scripting engine (vb LUA script).
    - Interactie: inlezen van data inputchip.
    - Configuratie: Linux- of distributie-specifiek beheer (vb scheduled tasks, verschillend op elk platform)
    - Andere: systeemstatistieken (output van collectd), hardware-monitoring, etc.
  - Beheer: de netwerk-API die de beheersapplicatie gebruikt om te communiceren met de kiosken moet tevens platform-onafhankelijk zijn. Translatie naar concrete systeemaanroepen verloopt dan via 1 van de bovenstaande systemen.
- Vlot
  - Minimale opstartsnelheid: zelfgeconfigureerde Linux-distributie zonder Desktop Environment of Window Manager (vb Qt direct bovenop fbdev via QWS)
  - HTML5/Javascript presentaties: door Qt te gebruiken valt de hele UI (met nadruk op het webgedeelte, QtWebKit) de accelereren via de GPU via de QGraphicsView widget. http://labs.qt.nokia.com/2010/05/17/qtwebkit-now-accelerates-css-animations-3d-transforms/ (http://labs.qt.nokia.com/2010/05/17/qtwebkit-now-accelerates-css-animations-3d-transforms/) De vereisten daarvoor zijn:
    - OpenGL 1.x of hoger
  - Videopresentaties: voor videoplayback voorzien de meeste backends en chips in acceleratie (Xv, VA-API, VDPAU), en QtWebKit moet te tweaken vallen om een Gstreamer/VLC backend te gebruiken voor de <video> tag http://apachelog.wordpress.com/2010/08/21/qtwebkit-video/

## Masterserver

Taken:

- Hosten van presentaties
- Monitoring van slaveserver en kiosken
- Aanbieden beheersinterface

Hoewel het mogelijk zou zijn het besturingssysteem van de kiosken op de masterserver de zetten (wat deployment zou vereenvoudigen en flexibiliteit verhogen), zou dit de taak van de secundaire slaveserver te complex maken. Ook zal het lokaal opslaan van het besturingssysteem de opstartsnelheid van de kiosken drastisch verlagen.

### Hardware

Vereisten:

- Processorsnelheid: er worden geen speciale eisen gesteld aan de processorsnelheid, daar de presentaties op voorhand verwerkt en gecomprimeerd zijn, en het hosten niet veel van de processor eist.
- Netwerksnelheid: naargelang de gekozen compressie moet voorzien worden in middelmatig snel (100 MB/s) tot snelle (1 GB/s) hardware.
- Opslag
  - Volume: gezien de recente evolutie van schijfcapaciteiten worden hier geen speciale eisen aan gesteld, zelfs indien alle presentatie in origineel formaat behouden worden.
  - Snelheid: zelf bij maximaal gebruik blijft het netwerk de limiterende factor, en worden geen zware eisen aan het opslagmedium gesteld.
  - Paralellisme: er moet wel getest worden of het streamen naar 10 kiosken tegelijk wel aan kan voldaan worden gezien de mogelijk hoge seek-times bij het lezen van niet-sequentiële data. Moest dit een probleem zijn, kan gebruik gemaakt worden van een opstelling die meerdere schijven kan benutten bij leesacties (vb RAID-5).
  - Redundantie: hoewel we slaveserver gebruiken om eventueel falen op te vangen, kan het van pas komen om ook op de masterserver de kans op falen van de hardeschijven (immers de meeste gevoelige component) te reduceren. Hierbij kan bijvoorbeeld ook een RAID-5 technologie van pas komen.

### Software (beheerssysteem)

Vereisten:

- Gebruiksgemak
- Features
  - Status van de kiosken (alive, activiteit, ...)
  - Informatie over de gezondheid van de kiosken
  - Statistieken van de presentaties

Specificatie:

- Netwerk:
  - WAN: 100 MB/s
  - LAN: 100 MB/s of 1 GB/s
- Opslag:
  - Besturingssysteem: 30GB SSD
  - Data: 2 x 300GB in RAID-5

### Software (besturingssysteem)

## Slaveserver

Taken:

- Monitoring van de masterserver
  - Controleren of de masterserver nog reageert
  - Notificatie van de administrator bij falen
- Redundantie
  - Mirroren van de presentatiebestanden
  - Taak overnemen van de masterserver bij falen
- Minder performant dan masterserver
- Minder mogelijkheden dan masterserver
  - Geen (of sterk beperkte) beheersinterface
  - Louter mirroren en hosten van de presentatiebestanden (geen interface om ze te wijzigen)

Een belangrijk punt is dat de slaveserver eenvoudig in gebruik is, of zelfs volledig autonoom functioneert, om in het geval dat de masterserver faalt de downtime te minimaliseren.

### Hardware

### Software

### Input-chip

Taken:

- Ingeven van toetsaandrukken in het systeem

Vereisten (hardware en software tesamen beschouwd wegens sterke overlap):

- Kost: te minimaliseren, exact budget vast te leggen (< €5).
  - Single-chip oplossing (V-USB ipv dedicated USB, AVR zonder 780n)
- Levensduur: lang, moet toekomstgericht gemaakt zijn
  - USB, en niet over seriële of parralelle bus.
- Energieverbruik: te minimaliseren
  - USB laat 500 mA toe, maar de meeste thinclients zullen dit niet halen, een limiet van 100mA (de specificatie voor battery-powered units) is veiliger.
- Uitbreidingsmogelijkheden
  - Multiplexed input (uitbreidbaarheid inputs)
  - Eenvoudig vervangen van de software (ISP, bootloader?)
- Gebruiksvriendelijkheid:
  - Geen nood aan extra drivers: geen FTDI oid, maar zich identificeren als USB Keyboard HID. Liefst zonder extra USB chip (V-USB?)
- Minimale latentie
  - Gebruikers verliezen snel interesse, de delay tussen een toetsenindruk en een zichtbare actie mag zeker de 500ms niet overschrijden (<150 ms wordt beschouwd als “onmiddelijk”).

Configuratie:

- Microprocessor: tinyAVR, moet wel V-USB aankunnen (2kb code, 128 bytes SRAM) alsook genoeg I/O pinnen hebben om zowel een ISP header als genoeg uitbreidingsmogelijkheden aan te kunnen. www.atmel.com/dyn/resources/prod_documents/doc4014.pdf
