maleadt/thesis-adastra3/scriptie/afbeeldingen/kiosk_binnenkant.jpg

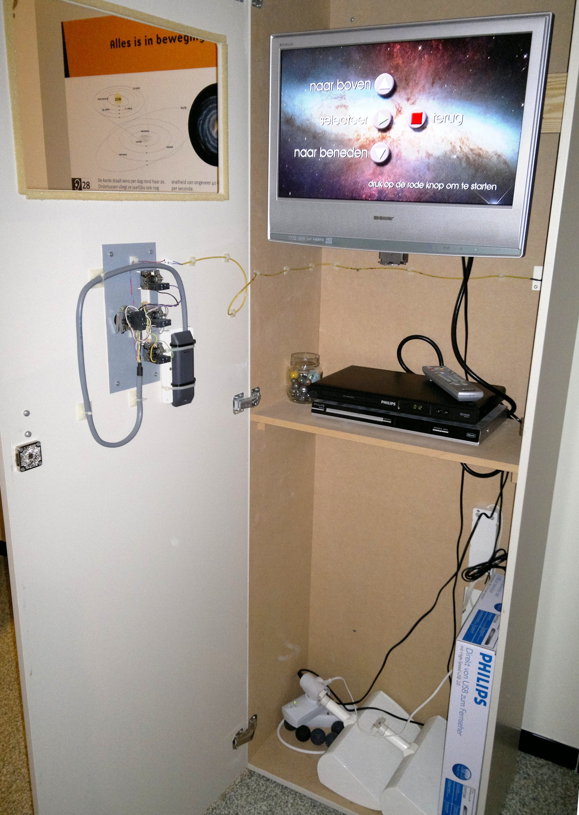
scriptie/afbeeldingen/kiosk_binnenkant.jpg
