maleadt/thesis-adastra3/verdediging/res/EFIKA_MX.jpg

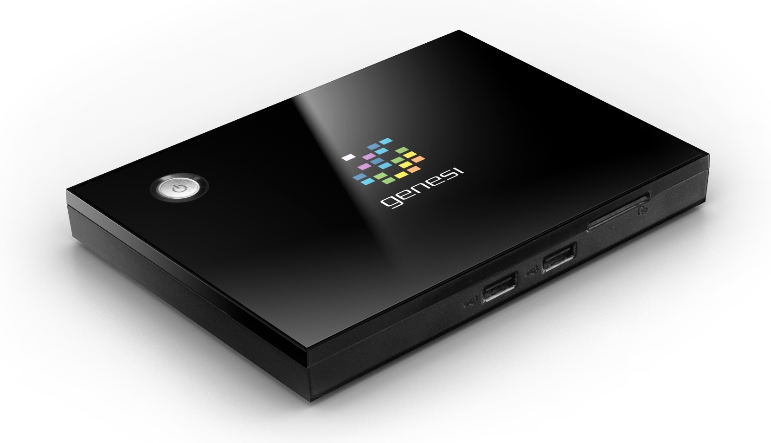
verdediging/res/EFIKA_MX.jpg
