maleadt/thesis-adastra3/verdediging/res/kiosk-intern.jpg

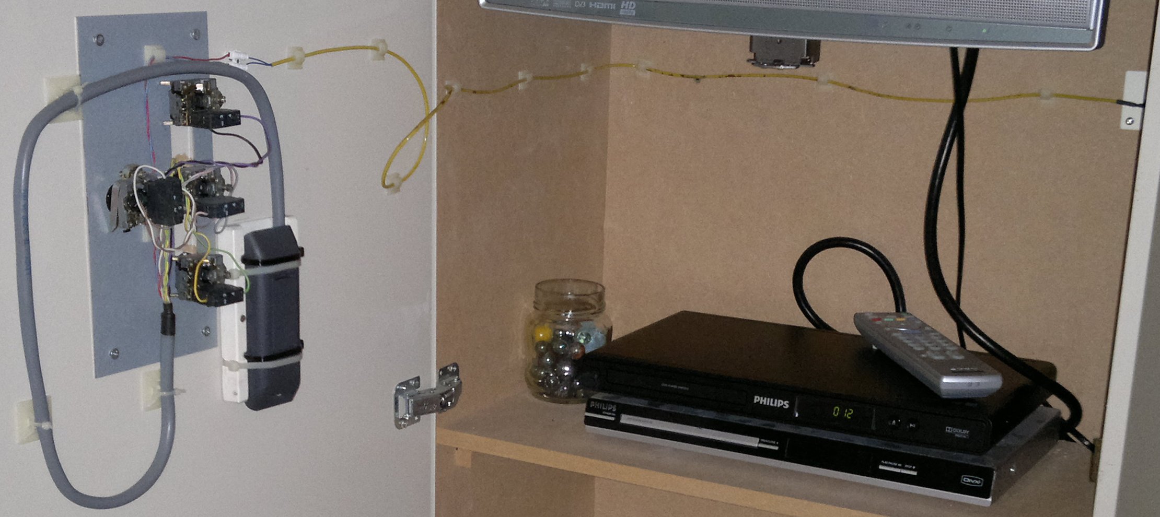
verdediging/res/kiosk-intern.jpg
