maleadt/thesis-adastra3/verdediging/res/kiosk.jpg

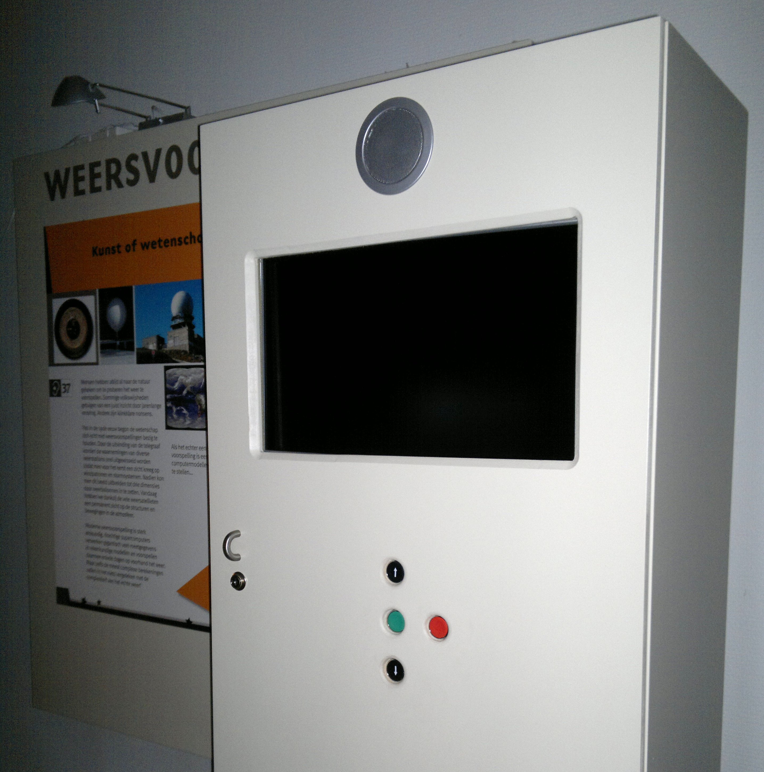
verdediging/res/kiosk.jpg
