maleadt/thesis-adastra3/verdediging/res/Synology_DS207+.jpg

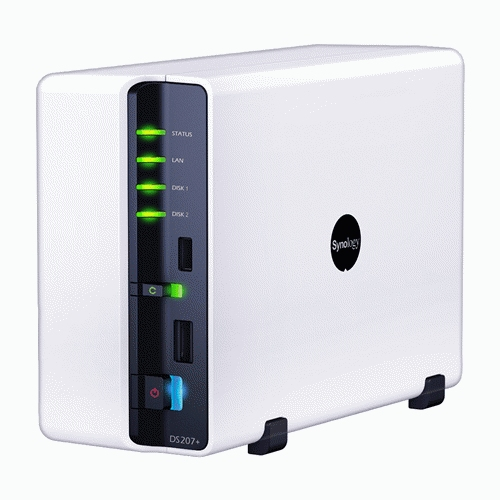
verdediging/res/Synology_DS207+.jpg
