maleadt/thesis-adastra3/(commit log)

2011-03-12 WIP snippets.
    [Kiosk hardware opties.ods, Kostenraming.ods]
2011-04-04 Toevoegen circuit screenshots.
    [circuit_isp.sch, circuit_schakelaars.sch, circuit_signaal.sch, circuit_voeding.sch]
2011-04-04 Foutje in voedingsschema.
    [circuit_voeding.sch]
2011-04-05 Fixes aan document.
    [Kiosk hardware opties.ods, Kostenraming.ods]
2011-04-10 Toevoegen relaas schakelaars.
    [circuit_schakelaars.sch]
2011-04-11 Opnieuw verbeteren.
    [circuit_schakelaars.sch]
2011-07-11 Renaming dissertation.
    [circuit_isp.sch, circuit_schakelaars.sch, circuit_signaal.sch, circuit_voeding.sch]
2011-07-13 Tekst over PCB.
2011-08-02 Renaming images as well.
    [circuit_isp.sch, circuit_schakelaars.sch, circuit_signaal.sch, circuit_voeding.sch, inputmodule_isp.sch, inputmodule_schakelaars.sch, inputmodule_signaal.sch, inputmodule_voeding.sch]
2011-08-06 Switchen naar lstlistings.
2011-08-06 Toevoegen tekst printplaat.
